downTheFallLine/crabora/software/walk/README.md

# CRABORA walk

Main gait and locomotion code. Starting fresh — the previous generation
(`walk.py` … `walk6.py`, `tripod_walk.py`, `stand*.py`, `take_step.py`,
`teach_pose.py`) was deleted on 2026-10-10 and is recoverable from git
history if a specific idea is worth retrieving.

This document fixes the conventions everything in here depends on.
Get these wrong and a gait that is mathematically perfect will walk
backwards, or tear a leg off against its neighbour.

## Body geometry

The body is a hexagon with one leg on each of the six flats, so a
**hexagon vertex (a "point") falls between each adjacent pair of legs**.

The **front of the robot is the point between leg 1 and leg 6.**

Legs are numbered **1 … 6 clockwise, viewed from above.**

```
                   FRONT
                     ·  ← front point, between legs 6 and 1
                    ╱ ╲
          6 ·                 · 1
          (330°)             (30°)

      5 ·                         · 2
      (270°)                     (90°)

          4 ·                 · 3
          (210°)             (150°)
                    ╲ ╱
                     ·  ← rear point, between legs 3 and 4
```

Bearings above are measured **clockwise from the front point**, which is
the natural reading of "clockwise order": leg *n* sits at
`30° + (n-1) × 60°`.

| Leg | Bearing | Position |
|-----|---|---|
| 1 | 30° | front-right  |
| 2 | 90° | right |
| 3 | 150° | rear-right |
| 4 | 210° | rear-left |
| 5 | 270° | left |
| 6 | 330° | front-left |

The rear point sits between legs 3 and 4, directly opposite the front.

Note there is **no leg on the centreline**, front or back. The robot
leads with a point, not with a leg, so forward motion is symmetric
about the 1/6 and 3/4 pairs.

## Body frame

Right-handed, origin at the body centre on the deck plane:

- **+X** forward, out through the front point
- **+Y** to the **left** (port)
- **+Z** up

So a leg's bearing θ (clockwise from front, as tabulated) maps to a
direction vector `(cos θ, −sin θ, 0)` — the sign on Y because bearings
run clockwise while the frame is right-handed.

This matches the usual robotics convention (ROS REP-103). It is a
choice, not a measurement: if anything else in the codebase already
assumes otherwise, change it **here** and fix the code, rather than
letting two conventions coexist.

## Servo IDs

Two-digit scheme, unchanged from the rest of the project:

```
    ID = leg × 10 + joint        joint: 1 = coxa, 2 = femur, 3 = tibia
```

| Leg | Coxa | Femur | Tibia |
|-----|---|---|---|
| 1 | 11 | 12 | 13 |
| 2 | 21 | 22 | 23 |
| 3 | 31 | 32 | 33 |
| 4 | 41 | 42 | 43 |
| 5 | 51 | 52 | 53 |
| 6 | 61 | 62 | 63 |

## Tripod groups

Alternating legs, which with this numbering gives two valid tripods:

- **Tripod A** — legs 1, 3, 5
- **Tripod B** — legs 2, 4, 6

Each group has two legs on one side and one on the other, straddling
the centre of mass. One tripod is always in stance while the other
swings.

## Mirror symmetry

Legs 1–3 are the right side, 4–6 the left. A leg and its mirror
(1↔6, 2↔5, 3↔4) are physically identical parts rotated into place, so
**a positive coxa command swings them in opposite directions in the body
frame.** Gait code must apply a per-side sign, not assume one direction
for all six.

This is the single most likely source of a leg driving into its
neighbour. It bit the previous generation — the tripod gait's coxa
direction was never verified on hardware.

**This generation's table is verified.** On 2026-10-10 `tripod_coxa.py`
drove all six coxas together on the test stand, with the two tripods
opposing as intended and no `--invert` needed. `FORWARD_SIGN` in
`gait_lib.py` is correct as written. `--invert` stays as a diagnostic:
if a later run needs it, a servo has been remounted.

## The femur

**Centre (2048) is the femur horizontal**, and the travel envelope is
**±90°** — straight up to straight down. Decided 2026-10-10.

### Why centre is horizontal

The alternative was centre = the neutral stance pose, which makes gait
maths read naturally (swing is a positive offset from zero) at the cost
of lopsided limits. Horizontal was chosen instead: it is a pose you can
identify by eye when calibrating, it is geometrically easy to reason
about, and it makes the limits symmetric. The price is that every stance
command carries a constant offset from centre.

### Up and down are not the same job

Unlike the coxa — where forward and rear are the same action mirrored,
so symmetric travel is natural — the femur's two directions do different
work:

- **Up** — swing clearance (small, 15–25°), and folding into a tuck or
  park pose (large). Also how the robot gets up from a collapsed start.
- **Down** — raises the body above neutral ride height. Useful range
  runs out quickly: as the femur drops the leg straightens, the foot
  pulls inward, and mechanical advantage falls away.

So although the *envelope* is symmetric at ±90°, the *useful* range is
not, and gait code should not assume that +30° and −30° are equally
available or equally cheap. Down is also gravity-assisted while up works
against the leg's weight, so the two directions differ in torque and in
how a move settles.

### Femur sign — verified

The coxa mirror comes from **body geometry**: legs 1 and 6 point
different ways, so "forward" is opposite rotations. The femur has no
equivalent — *lift is the same physical motion on every leg.*

So the femur sign should be **uniform across all six legs, not mirrored
like the coxa.**

**Confirmed on hardware 2026-10-11.** All six femurs moved together, so
the reasoning holds and one sign serves every leg. The run also showed
the direction was backwards from the first guess: **a rising servo count
LOWERS the femur**, so `FEMUR_UP_SIGN` in `gait_lib.py` is −1 everywhere,
not +1.

If a later run shows the two sides splitting — legs 1–3 rising while 4–6
drop — a servo has been remounted and the table would need per-side
values after all.

### Travel limits

Pick them from the hardware, not from this document. With torque off,
swing each femur by hand through its full range and find where it
actually fouls — cap against coxa body, tibia against femur, leg against
neighbour — then set limits a few degrees inside that. `set_center.py`
takes independent left/right values, so asymmetric limits need no new
code:

```
python3 utils/set_center.py 12 50 25     # leg 1 femur: 50° up, 25° down
```

## The tibia

**Centre (2048) is the tibia COLLINEAR WITH THE FEMUR** — the leg dead
straight, zero knee bend. Decided 2026-10-11.

### Why collinear

The deciding factor is **repeatability across six legs**. Centre is set
six times by hand with `set_center.py`, and the legs have to match. A
straight leg can be pressed against a table edge or a straightedge — it
is physically repeatable, not judged by eye. The alternative (tibia
perpendicular to the femur) means eyeballing a right angle six times,
and if leg 3 ends up 5° off leg 1 the robot limps in a way that is
miserable to trace back.

Secondary: zero knee bend = zero is the standard way to parameterise a
knee, so the tibia angle is simply "flexion from straight" for any IK
written later. And it is the same *kind* of reference as
femur-horizontal — a geometric datum you can verify, not a working pose.

### Travel is one-sided

A knee only bends one way, so **straight is the edge of useful travel,
not the middle.** There is almost nothing on the extend side and all of
it on the flex side — roughly 0 to 120–135° of flex. Firmware limits
will be lopsided (something like 5° extend, 120° flex) and that is
correct, not a mistake: nothing requires centre to be centred.

The direct consequence is that **code sweeping this joint symmetrically
is the wrong shape.** `proto_walk_tibia.py` therefore takes separate
`--extend` and `--flex` angles rather than one `--angle`; a symmetric
sweep would clamp against the extend limit on every leg, every rep.

### Tibia sign

`TIBIA_EXTEND_SIGN` is **+1 everywhere, verified on hardware 2026-10-12**
(`tests/test_05_calibration.py --signs --legs 1 4`). Both predictions
from the other two joints held except one:

- **Uniform across all six, not mirrored** — as expected. Legs 1 and 4
  are one per side and both extended, so the sides did not split. Flexing
  a knee is the same physical motion on every leg, exactly as lifting is
  for the femur. The coxa's mirror comes from body geometry and has no
  analogue at the knee.
- **+1, not −1** — the femur needed inverting from its first guess and
  this one did not, so the tibia servos do *not* follow the femur's
  mounting convention.

This was the last unverified joint sign. All three tables in
`gait_lib.py` now match hardware.

## Link geometry

Read from the CAD and confirmed against the built leg with calipers on
2026-10-11. All distances are between **joint axes** — the centre of
each servo horn — which is the kinematic quantity, not part edges.
They live in `gait_lib.py`.

| Parameter | Value | Meaning |
|---|---|---|
| `BODY_TO_COXA_AXIS` | 163.22 mm | body centre → coxa axis, horizontal, along the leg's bearing |
| `COXA_RADIAL` | 58 mm | coxa axis → femur axis, outboard |
| `COXA_TANGENT` | 21 mm | coxa axis → femur axis, **sideways** |
| `COXA_VERTICAL` | 17.6 mm | coxa axis → femur axis, up |
| `FEMUR_LEN` | 100 mm | femur axis → tibia axis |
| `TIBIA_LEN` | 120 mm | tibia axis → foot tip |

### The leg is not a planar 2-link chain

Worth flagging because it is easy to get silently wrong: the femur axis
is **not** directly outboard of the coxa axis. It is displaced 21 mm
sideways and 17.6 mm up. So the femur/tibia plane is offset from the
coxa rotation axis rather than passing through it.

Any IK written against the textbook "yaw joint plus planar 2-link"
model will be subtly wrong — the tangent term has to be carried through.
The error would be small enough to look like calibration drift, which
is the worst kind of bug to chase.

### Measuring these again

If a leg revision changes them, there is an easy repeat procedure now
that the centre conventions are fixed. Command one leg to centre on all
three joints — coxa neutral, femur horizontal, tibia collinear — and
**the leg becomes a straight horizontal line from the femur axis out to
the foot.** Everything is then measurable with a steel rule in one pose,
with no angles to judge. Measure horn-centre to horn-centre; the central
horn screw marks the axis.

## Still undefined

Deliberately not fixed here yet, because they want measuring on the
assembled robot rather than guessing:

- ~~Joint zero poses~~ — all three are now settled: coxa neutral, femur
  horizontal, tibia collinear with the femur. Set them with
  `software/utils/set_center.py`.
- ~~Joint angle signs~~ — all three are settled and verified on
  hardware: coxa 2026-10-10, femur 2026-10-11, tibia 2026-10-12.
- ~~Travel limits~~ — set on hardware as of 2026-10-11. Every joint's
  safe swing is now written into servo firmware, so a bad command is
  clamped by the servo itself rather than by the calling code.

## Bring-up order

Power is the binding constraint (see the project power notes — the
LM2596 buck tops out around 2–3 A, which is fine for exercising joints
but will not stand the robot). Build up a tier at a time:

1. All six coxas bolted → `software/tests/test_04_coxa_sweep.py`
2. Add femurs → `software/utils/swing_legs.py --mode by-joint`
3. Add tibias → same, then static stance
4. Standing, then walking — needs the power path sorted first

## walk.py

Translates the body across the floor with the feet planted. **The idea is
`turn.py`'s, with translation substituted for rotation** — both are "foot
fixed in the world, re-solve the leg", and the only difference is what the
body does between solves:

| | the planted foot appears to |
|---|---|
| turn | rotate about the body centre |
| walk | translate, opposite the heading |

That discipline is the whole point. Swinging the coxa and hoping is what
lost two thirds of the first turn: the foot slid radially, and a foot
sliding radially has no grip to push with either.

A hexagon with radial legs has no mechanical front, so it walks sideways
and backwards without turning first — heading is just a vector. 0 is
forward (the point between legs 1 and 6), 90 left, 180 back, 270 right.

```bash
python3 walk.py 300 --dry-run        # geometry only, touches nothing
python3 walk.py 300                  # 300 mm forward, 100 mm deck
python3 walk.py 200 --heading 180    # backwards
python3 walk.py 400 --stride 150     # longer steps, fewer of them
```

`--instrument` measures what actually happened, rather than what was
commanded: swing-foot clearance after each LIFT and SWEEP, body tilt at
the same points, and the heading change across the whole walk.

That last one is the only thing the walk can measure that a static test
cannot. A straight walk should end on the heading it started on; if it
veers, that is **asymmetric slip** — one side gripping better than the
other — and it is invisible by eye over 150 mm.

The clearance figures are computed from joint angles, which makes them
**body-relative**: they measure the swing foot against the stance feet,
and when the body sinks, both move down together. The tilt reading is
there to catch what they cannot. Note an accelerometer sees tilt but not
uniform sink, so the two together still do not replace a ruler.

**Default height is 100 mm**, not 80. The femur caps hang 21 mm below the
deck and the body drops another ~13 mm when a tripod lifts, so 80 leaves
about 46 mm of real gap under the lowest hardware against 66 at 100.
Measured on hardware 2026-10-14: standing at 94 mm gave 73 mm under the
caps and a clean tripod lift, where 75 mm did not. The stride cap falls
from ±84 mm to ±72 mm, still far more than a 50 mm stride needs — so the
height costs nothing that matters.

`--dry-run` prints the per-leg coxa angles at both sweep extremes, which
is where the asymmetry shows: walking forward, the **beam legs (2 and 5)
sweep most** (±8.0° at a 25 mm half-stride) because they are
perpendicular to travel, so their motion is almost pure tangent. The
corner legs take ±4.6°, since part of their motion is radial — a reach
change rather than a coxa swing. Which legs have the hard job depends on
the heading, so the stride cap is computed per leg.

**Verified in simulation, not on hardware.** Foot drift through a full
sweep is 0.000000 mm on forward, backward, left, right and diagonal
headings — the same check `turn.py` had to pass. Stride is capped by
whichever comes first, leg reach or the coxa limit: ±84 mm forward, ±77 mm
sideways at 80 mm height. None of that is the same as having walked.

## scurry.py

walk.py's gait, streamed on a clock instead of stop-and-wait. walk.py
sends a frame, then polls all 18 servos until every one has stopped,
seven times a step at 300 steps/s. That is how it learned the gait works,
and it is why the robot stops dead seven times a step.

scurry.py instead computes, at a fixed rate (50 Hz), where every foot
should be at that instant and sends all eighteen goals in one sync-write
packet per URT. No replies, no waiting. The geometry is walk.py's
`stance_pose()`, unchanged; what is new is the timing:

- each tripod is down for `--duty` of the cycle (0.55), so both tripods
  are briefly on the floor together at each changeover
- the swing foot leaves and lands moving with the floor (a Hermite curve
  on the stride, a raised cosine on the femur), so lift-off and
  touchdown carry no velocity jump
- the cycle rate ramps up over the first period and down over the last

```bash
python3 scurry.py 500 --dry-run          # plan, joint speeds, touches nothing
python3 scurry.py 500                    # 3 s cycles, ~67 mm/s
python3 scurry.py 500 --period 2.5       # then shorten a step at a time
```

**It is open loop.** walk.py knew whether each joint arrived; this does
not ask. In place of that it reads supply voltage every 0.2 s and stops
below `--min-volts` (6.5), and ends the run on any bus error. Stopping
means planting whichever feet are up and holding, torque on. It also
reads one servo's real position and current every 0.05 s, round-robin,
and reports each joint's tracking error and lag at the end -- a
measurement, not a guard. The currents show live in agentix.

**Speed: stride is cheap, lift is expensive.** The femur does all the
lifting, inside the swing, so its speed scales with lift and not
stride; body speed scales with stride and not lift. So scurry's
defaults differ from walk.py's: a 120 mm stride (asked; capped to what
the legs hold, swing overshoot included), 20° lift, and feet 110 mm out
instead of 120 (it moves them in from the stand pose and back). At the
default 3 s period that plans ~67 mm/s, against ~30 mm/s with walk.py's
geometry.

`--dry-run` refuses anything needing over 1500 steps/s from any joint
(half an unloaded STS3215, as a guess at what a loaded one will follow)
unless `--allow-fast` is passed. The tracking report is how to replace
that guess. `--period 1.7 --duty 0.5` plans ~118 mm/s with the tibia at
~1420. Past a ~1.6 s period the stream needs more acceleration than the
servo register holds (25,400 steps/s²), so the plan sets it unlimited
and suggests `--rate 100`.

**Not yet run on hardware.** Tested against a fake bus: 50 Hz held with no
late frames, the packets decode with valid checksums, and the low-voltage
stop plants and holds.
