downTheFallLine/crabora/doc/mounts-spacer.md

## Mounts & Standoffs

### Coxa Connection

1.	Use 12.5mm spacer
2.	Use 20mm bolt

### Femur Connection

1. Use 6MM spacer
2. Use 14MM bolt

### Tibia Connection

1. Use 6MM spacer
2. Use 14MM bolt

### Coxa Cap

4x50mm bolts

### Femur Cap

4x40mm bolts

### Tibia Cap

4x45 or 4x50 bolts   50 preferred
