downTheFallLine/crabora/imu/imu_bracket.png

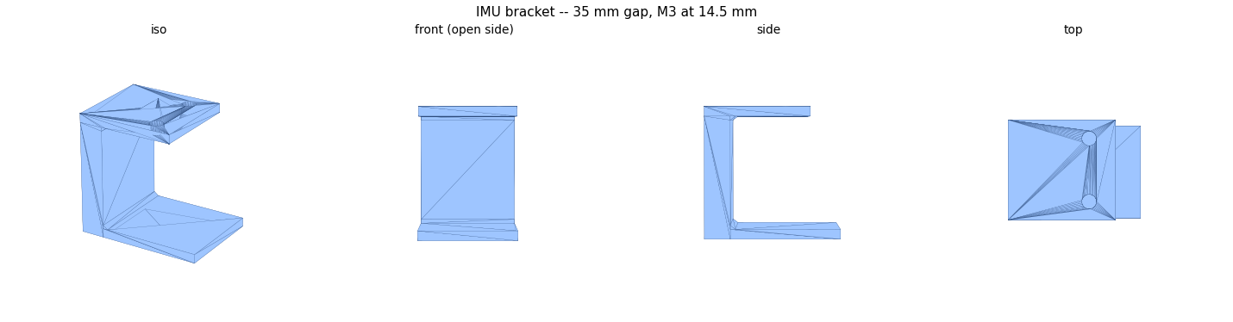
imu/imu_bracket.png
