downTheFallLine/crabora/leg/coxa/coxa_body_cap.png

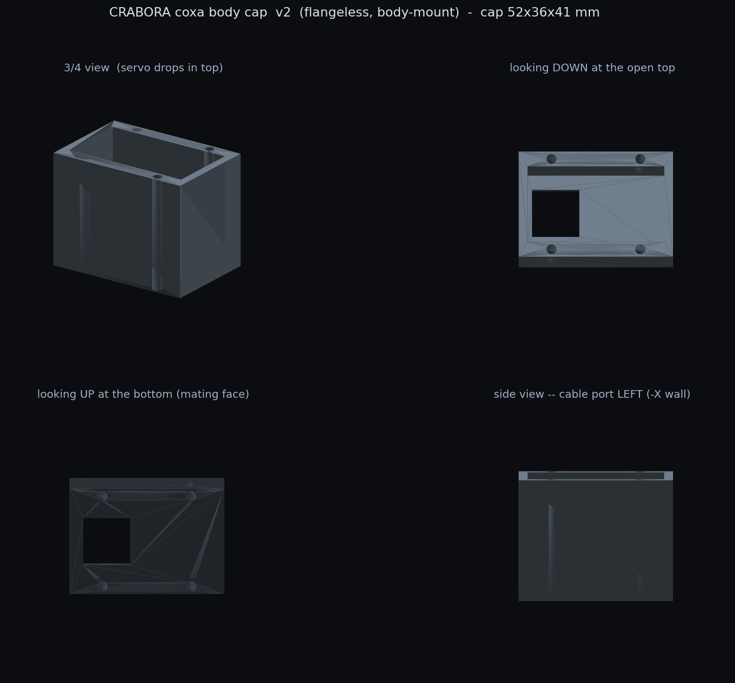
leg/coxa/coxa_body_cap.png
