downTheFallLine/crabora/leg/coxa/coxa_body_mount.png

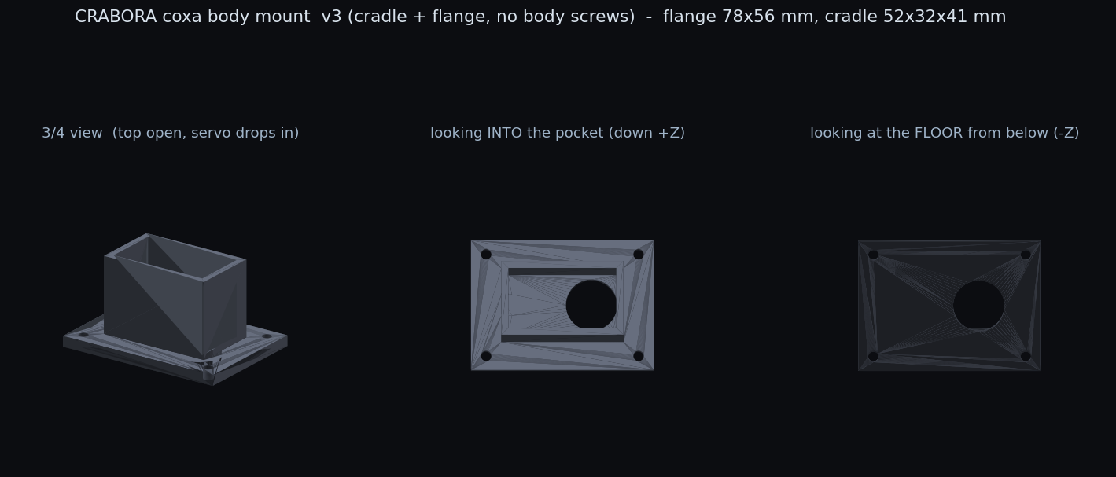
leg/coxa/coxa_body_mount.png
