downTheFallLine/crabora/leg/coxa/linkage_leg/coxa_pan.png

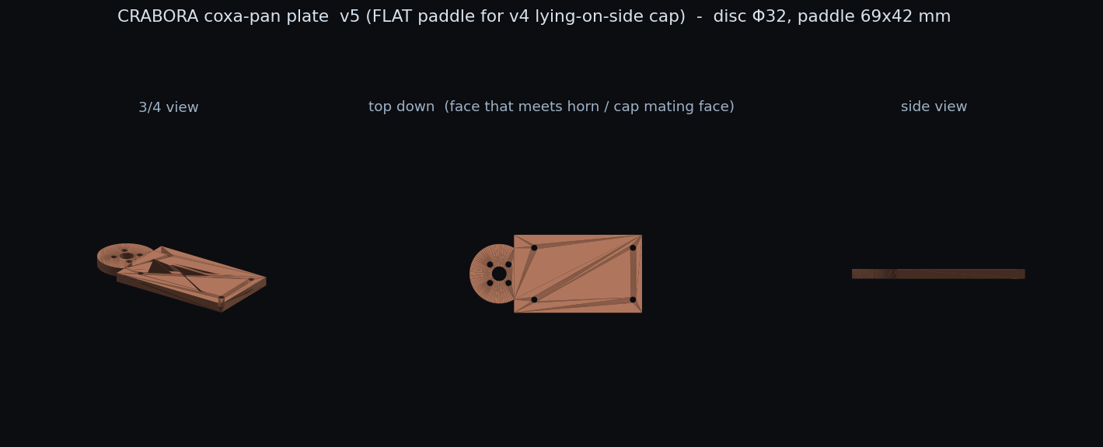
leg/coxa/linkage_leg/coxa_pan.png
