downTheFallLine/crabora/leg/femur/femur_cap.png

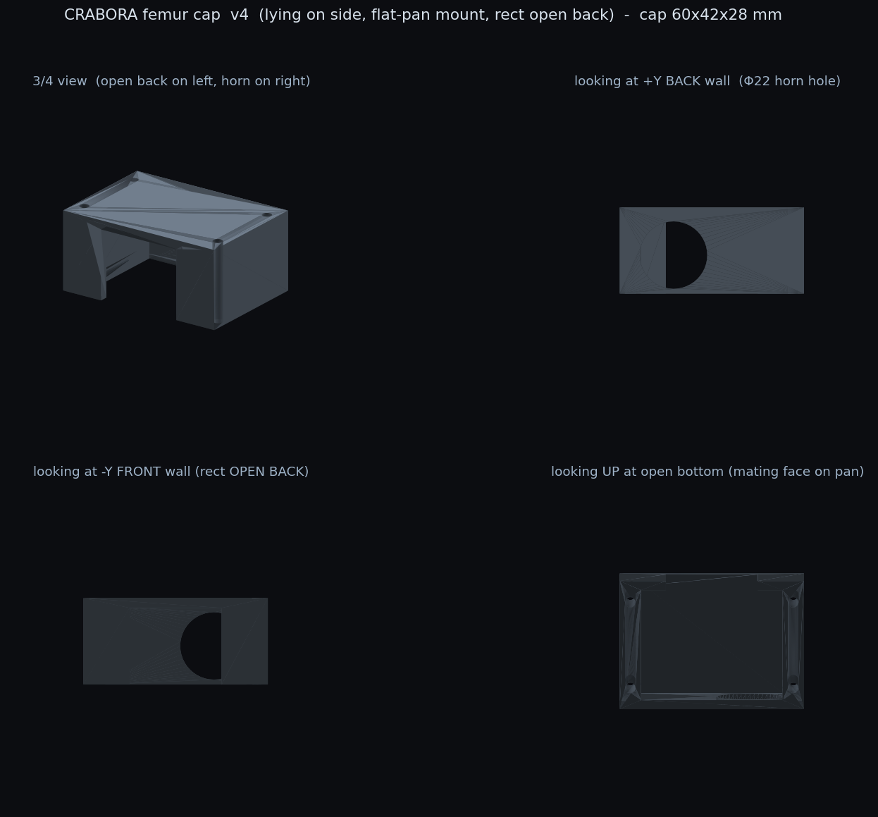
leg/femur/femur_cap.png
