downTheFallLine/crabora/leg/femur/linkage_leg/femur_link.png

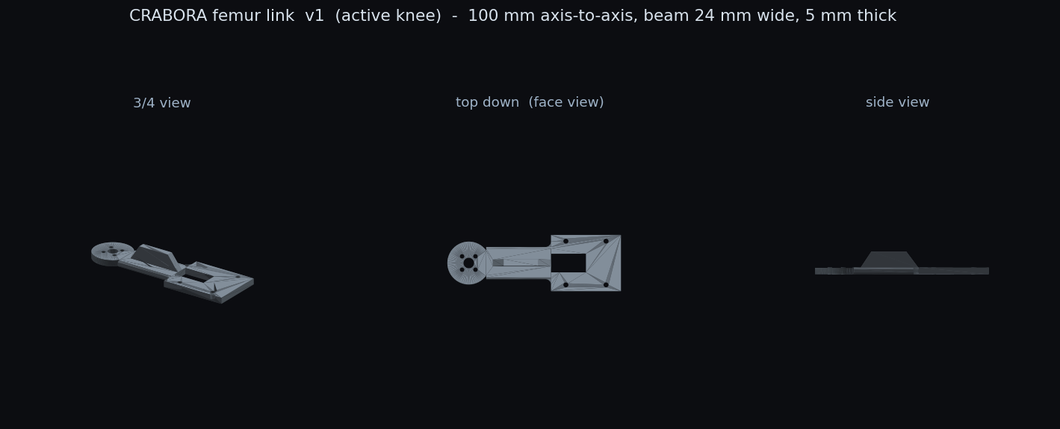
leg/femur/linkage_leg/femur_link.png
