downTheFallLine/crabora/leg/tibia/linkage_leg/tibia_link.png

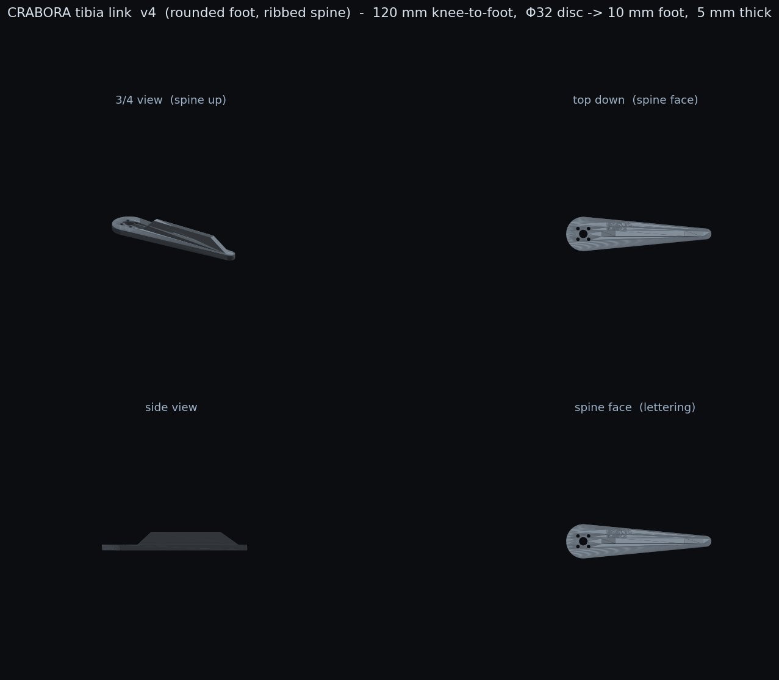
leg/tibia/linkage_leg/tibia_link.png
