downTheFallLine/crabora/leg/tibia/tibia_cap.png

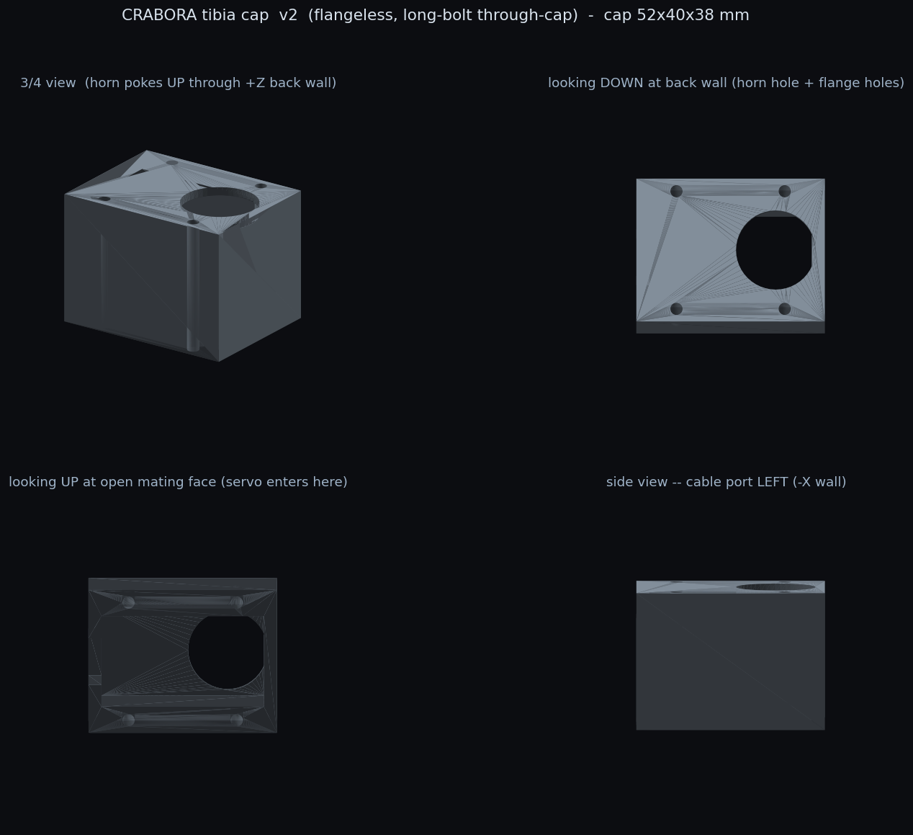
leg/tibia/tibia_cap.png
