downTheFallLine/crabora/sled/buck_sled.png

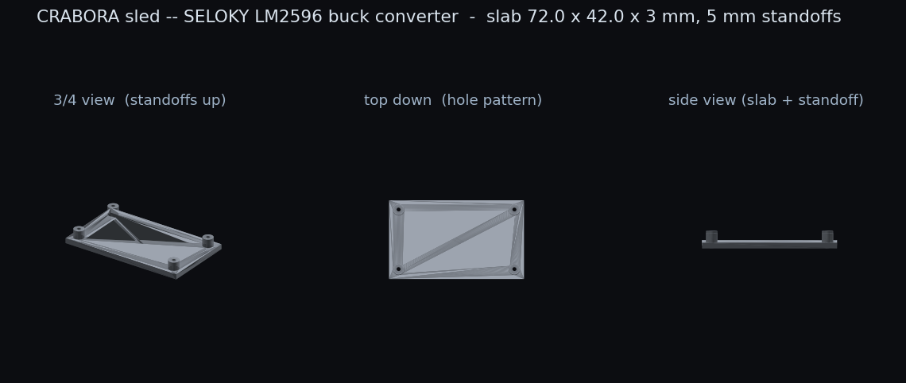
sled/buck_sled.png
