downTheFallLine/crabora/spacer/spacer/horn_spacer.png

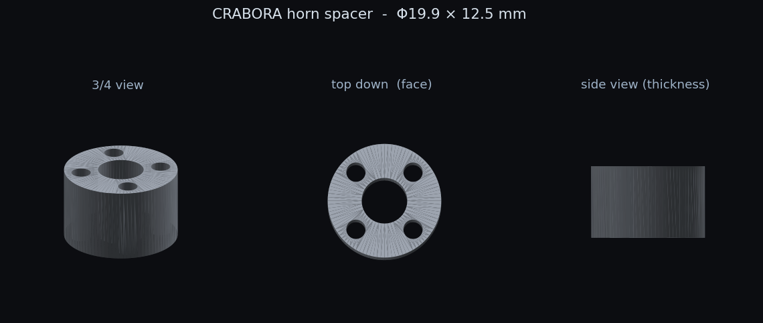
spacer/spacer/horn_spacer.png
