downTheFallLine/crabora/doc/Crabora-status.xlsx

Sheet: Read me
CRABORA — project state
Six-legged robot. Feetech STS3215 servos on 3x FE-URT-2, driven from a Raspberry Pi running Ubuntu.
What this workbook is
A snapshot of where the project stands as of 14 October 2026, built to make the open questions visible rather than to track tasks.
The sheets
Status every subsystem, what state it is in, and how that was established
Open items what is left, ordered by what blocks what
Measurements every number taken off the hardware, with its source and how far to trust it
Decisions choices made and why, so they are not relitigated
Changes what was built and fixed on 13-14 October
The one thing to take away
Power is the root problem. The buck converter has NEVER regulated: a 2S pack feeds an LM2596 asked for 7.4 V, which needs ~9.4 V in, so servo voltage simply tracks the battery down all session. Supply fell 6.5 → 5.5 V over one evening, below the servos' 6.0 V minimum.
Because of that, repeating a measurement an hour later gave a different answer, and a great deal of time went into chasing robot problems that were battery problems. Until it is fixed, every number here has a shelf life.
Confidence, as used throughout
HARDWARE measured on the robot, repeated or cross-checked
SIM computed or simulated only; never run on the robot
EYE observed by a person, not instrumented
ASSUMED carried forward without evidence; treat as a guess

Sheet: Status
Subsystem status
State and how it was established. Colour follows state; see the Read me for what each confidence level means.
Subsystem | State | Confidence | What is true today | Established by | Where
Joint sign calibration | DONE | HARDWARE | All three signs verified: coxa mirrored, femur -1, tibia +1, none of them guessed any more. | test_05_calibration.py --signs, 12 Oct | software/walk/gait_lib.py
Travel limits | DONE | HARDWARE | Set in servo firmware, identical across all 18 joints. Coxa +/-60, femur +/-80, tibia -135..+90. | test_05_calibration.py | servo firmware
Stand / recovery | WORKS | HARDWARE | Collapse, untangle, stand. Reaches 94-100 mm deck. Four legs fell short once at 150 mm, which is 90% of max reach. | stand.py, 14 Oct | software/stand/stand.py
Untangle | WORKS | HARDWARE | Rewritten to fold all six legs then rotate all six coxas, instead of one leg at a time. Safer: nothing rotates while a neighbour is extended. | stand.py, 14 Oct | software/stand/stand.py
Tripod lift | DONE | HARDWARE | 90 mm of clearance at 35 deg, confirmed by eye and by IMU. Femurs reach within 0.3 deg. Body tilts only 0.87 deg. | test_07_tripod_lift.py, 14 Oct | software/tests/
Walk | UNRUN | SIM | Planted-foot gait, same maths as turn with translation substituted for rotation. Foot drift 0.000 mm in simulation on five headings. NEVER RUN ON HARDWARE. | simulation only | software/walk/walk.py
Turn | UNVERIFIED | EYE | Planted-foot sweep. Originally 90 deg commanded produced 30-45 deg measured by eye. Never instrumented; the IMU can now measure it directly. | eye, before the IMU existed | software/turn/turn.py
Dance | WORKS | EYE | Runs. Never instrumented or measured. | ran on hardware | software/dance/dance.py
IMU | PARTIAL | HARDWARE | Wired, detected at 0x68, reading tilt. NOT CALIBRATED: |g| reads 1.042 on every sample, a constant 4% scale error. Differences are still trustworthy; absolute tilt is not. | test_06, 14 Oct | software/imu_lib.py
Power / supply | BROKEN | HARDWARE | The buck has never regulated. 2S into an LM2596 asked for 7.4 V needs ~9.4 V in. Observed 6.5 V falling to 5.5 V in one session, below the 6.0 V servo minimum. | read_servo_voltage.py, repeatedly | hardware
Bus reliability | DONE | SIM | Lost replies now retried twice and counted, so a motion that limped through says so. Serial exceptions caught rather than escaping as tracebacks. | synthetic packet handler | software/walk/gait_lib.py
agentix service | WORKS | HARDWARE | Runs at boot via systemd, serves the UI, holds the servo ports. Credentials in /etc/crabora/agentix.env, root-owned 0600. | running on the Pi | software/agentix/
agentix motion tools | UNRUN | SIM | Seven motions behind a human ARM switch the agent cannot flip. Argument rejection and the gate are verified; no motion has ever executed. | static checks only | software/agentix/motion.py
agentix chat | UNRUN | ASSUMED | Needs an org-level key plus ANTHROPIC_WORKSPACE_ID, or a workspace-scoped key. Never completed a request. | never run | software/agentix/agent.py
IMU bracket | PARTIAL | SIM | C-section sled, 35 mm gap, M3 at 14.5 mm. Geometry verified in 3D. Not yet printed or fitted. | geometry checks | imu/design_imu_bracket.py
WiFi hotspot | UNRUN | SIM | Fallback AP so the robot is reachable away from the house network. Exercised against a stubbed nmcli; no real radio has run it. | stub only | software/net/hotspot.sh

Sheet: Open items
What is left, in order
Priority is about what blocks what, not about how interesting it is. The two blockers are both power.
Priority | Item | Effort | Why it matters | Blocked by | Unblocks
1 BLOCKER | Charge the battery | Minutes | Supply fell to 5.5 V, under the servos' 6.0 V minimum. Every measurement taken below that is a measurement of the battery. | Nothing | Everything downstream
1 BLOCKER | Move to a 3S pack | An afternoon | The real fix. 2S can never give the LM2596 its ~2 V of headroom, so servo voltage tracks the battery down and nothing reproduces. 3S regulates properly all session. | Parts | Repeatable measurement of anything
2 HIGH | Calibrate the IMU | Minutes | |g| = 1.042 on every sample. Until this runs, absolute tilt carries a 4% scale error. | Nothing | Trustworthy absolute tilt
2 HIGH | Run the instrumented walk | An hour | The measurement the whole project is waiting on. Gives three numbers at once: distance travelled vs commanded, heading drift (asymmetric slip), and whether clearance collapses mid-sweep. | Charged battery | Whether the robot walks
2 HIGH | Tape-measure the actual distance | Minutes | No sensor on this robot can measure translation; accelerometer double-integration drifts uselessly within seconds. A tape is the instrument. | The walk running | Slip vs scrub, settled
3 MEDIUM | Verify the turn with the IMU | An hour | turn.py exists because 90 deg commanded gave 30-45 by eye. Yaw measures it directly, and over a few seconds gyro drift is negligible. The IMU's most reliable use here. | Charged battery | turn --efficiency becomes calibration not guesswork
3 MEDIUM | Reconcile TRIPOD_SAG | Minutes | Still the 13 mm ruler figure, which measures uniform sink. The IMU reports 5 mm of lean. Different quantities; both are real and the constant should say which it is. | A walk on a good battery | Honest clearance predictions
3 MEDIUM | agentix with a real API key | An hour | The motion path has never executed. Everything is verified statically, which is not the same as having run. | Key with workspace scope | The agent can actually drive the robot
4 LOW | Print and fit the IMU bracket | A print | The IMU currently has no proper mount. Nothing on the bracket keys its orientation, so fitting it backwards inverts every heading. | Printer time | A repeatable IMU mounting
4 LOW | Decide turn and dance heights | Minutes | Both still default to 80 mm while stand and walk moved to 100. Deliberately left: a turn loads the legs differently and deserves its own measurement. | A verified turn | Consistency, or a reason not to be
4 LOW | Delete the git backup refs | Minutes | backup-before-purge and backup-branch still hold ~26 MB of pre-purge history locally. Safe to drop once the Pi is confirmed happy. | Confidence in the Pi | 26 MB
4 LOW | Decide on software/dance.sh | Minutes | Exists only on the Pi, untracked. Either commit it or delete it. | Nothing | One less loose end

Sheet: Measurements
Everything measured off the hardware
SIM values are computed from the geometry and have been wrong before — the computed clearance was optimistic for a whole evening because it cannot see the body move.
Area | Quantity | Value | Unit | Confidence | Source | Notes
Geometry | BODY_TO_COXA_AXIS | 163.22 | mm | HARDWARE | Calipers, 11 Oct | Body centre to coxa axis
Geometry | COXA_RADIAL | 58 | mm | HARDWARE | Calipers, 11 Oct | Coxa axis to femur axis, outward
Geometry | COXA_TANGENT | 21 | mm | HARDWARE | Calipers, 11 Oct | Sideways offset. The leg is NOT a planar 2-link chain because of this.
Geometry | COXA_VERTICAL | 17.6 | mm | HARDWARE | Calipers, 11 Oct | Coxa axis to femur axis, vertical
Geometry | FEMUR_LEN | 100 | mm | HARDWARE | Calipers, 11 Oct | Femur axis to tibia axis
Geometry | TIBIA_LEN | 120 | mm | HARDWARE | Calipers, 11 Oct | Tibia axis to foot tip
Geometry | CAP_DROP_BELOW_DECK | 21 | mm | HARDWARE | Ruler, 13 Oct | Femur caps hang this far below the deck. The kinematics did not know they existed; leg_fk measures to the femur AXIS.
Sag | TRIPOD_SAG (uniform sink) | 13 | mm | HARDWARE | Ruler, 13 Oct | Chassis went 46 -> 33 mm when one tripod lifted, while the stance femurs gave about 1 deg. Mechanical: flex, backlash, feet sliding.
Sag | Body lean when a tripod lifts | 0.86-0.87 | deg | HARDWARE | IMU, 14 Oct, twice | Repeated across two runs on different stances, so this is signal not noise. Equals ~5 mm at a foot 341 mm out.
Clearance | Swing foot lift at 35 deg | 90 | mm | HARDWARE | test_07, 14 Oct | Confirmed by eye as well as computed. At 25 deg it was 57 mm.
Clearance | Gap under caps, standing at 100 mm deck | 79 | mm | SIM | computed | deck height minus the 21 mm cap drop
Clearance | Gap under caps, tripod lifted, 100 mm deck | 66 | mm | SIM | computed | minus the 13 mm measured sink. 80 mm deck gives only 46.
Lever | Foot rise per degree of FEMUR | 2.09 | mm/deg | SIM | computed at a standing pose | The only useful lever for lifting a foot.
Lever | Foot rise per degree of TIBIA | -0.41 | mm/deg | SIM | computed at a standing pose | NEGATIVE: more tibia flex LOWERS the foot, and throws it 2 mm outward per degree.
Lever | Body height lost per degree of femur sag | 2.08 | mm/deg | SIM | computed | Constant across stand heights.
Power | Supply at session start | 6.5 | V | HARDWARE | read_servo_voltage, 13 Oct | Already below the 7.4 V the buck is set for.
Power | Supply at session end | 5.5 | V | HARDWARE | test_07, 14 Oct | BELOW the STS3215's 6.0 V minimum. Rose to 5.8 V the moment three legs unloaded.
Power | Servo spec range | 6.0 - 7.4 | V | ASSUMED | vendor listings, not the datasheet | Sources conflict; one outlier says 8.4. The servos store their own limits in registers 14/15 — read those.
Gait | Foot drift through a sweep | 0.000 | mm | SIM | simulation, 5 headings | The planted-foot solve is exact in the model. Any real sliding is traction, not commanded scrub.
Gait | Stride capacity, forward at 100 mm | +/-72 | mm | SIM | computed | Far more than the 50 mm default stride needs.
Gait | Beam legs (2,5) coxa sweep, forward | +/-8.0 | deg | SIM | computed | Against +/-4.6 for the corner legs: beam legs are perpendicular to travel so their motion is nearly pure tangent.
Bracket | IMU bracket resonance | ~471 | Hz | SIM | cantilever calculation | A foot plant rings the structure at 50-200 Hz, so the mount stays clear. A 4 mm web would have been 310 Hz.

Sheet: Decisions
Decisions and why
Recorded so they are not relitigated, and so the reasoning survives when the context does not.
When | Decision | Why | Cost / trade | Caveat
14 Oct | Stand and walk default to 100 mm, not 80 | 80 predates knowing the femur caps hang 21 mm below the deck and the body sinks another 13 mm. That leaves 46 mm under the lowest hardware, which is where the chassis bottoms out instead of the legs holding it. | Stride capacity falls from +/-84 to +/-72 mm, still far more than needed. | turn and dance stay at 80 pending their own measurement.
14 Oct | Untangle moves all six legs together | One leg at a time still let a leg rotate its coxa while neighbours lay extended — the 440 mm lever sweep the phase exists to prevent, just between legs instead of within one. | No extra current: collapse already moved six femurs at once. | Femurs before tibias, same ordering lesson that cost a tibia.
14 Oct | Gait programs REFUSE when the service holds the bus | It was a warning, and it was answered past three times running, each time corrupting a move and stranding the robot mid-sequence. | --force exists but has never worked. | The service holds the ports even when the chat agent is disabled — those are different things.
14 Oct | Default lift 35 deg, not 25 | Buys 90 mm of clearance against 57 for nothing; the femur has travel to spare. | Exposed a settle bug that 25 deg had been hiding. | Treats a symptom if the body is sinking — not a substitute for height.
13 Oct | The femur is the lift lever, not the tibia | Measured: femur 2.09 mm/deg against the tibia's -0.41, and more tibia flex LOWERS the foot while throwing it outward. | Settles a natural but wrong instinct. | Checked numerically after it was proposed, not assumed.
13 Oct | Bus retries are counted and reported | A retry that hides a fault is worse than the abort it replaces: a browning-out supply drops packets exactly like a loose connector. | A motion completing after forty re-sends now says so. | Only safe because goal/speed/torque writes are idempotent.
12 Oct | agentix motion sits behind a human ARM switch | The failure worth designing against is not a model going berserk, it is a robot left armed on a bench that lurches when someone later asks an innocent question. | Window expires on idle, hard ceiling at 30 min, dropped by STOP. | The agent cannot arm itself: /api/arm is unreachable from the tool layer.
12 Oct | Motion reuses the verified CLI programs | Two tibias have snapped from motions that looked geometrically reasonable. Nothing in the agent layer invents a trajectory. | turn.py's sweep was lifted out of main() rather than copied. | A second copy of a gait is how the third tibia breaks.
12 Oct | Credentials live outside the repo | A key in a working tree is one `git add -A` from being published — which is exactly how 177 MB of venv got committed later the same day. | /etc/crabora/agentix.env, root-owned 0600. | The .gitignore now uses .venv*/ after the venv leak.

Sheet: Changes
Built and fixed, 13-14 October
Not a changelog — the entries that changed what is known about the robot.
Area | What changed | Why it mattered | Where
IMU | Wired and brought up on Ubuntu | raspi-config does not exist there and the boot config is at /boot/firmware/config.txt, which no MPU-6050 guide mentions. | doc/imu.md
IMU | Attitude measurement in test 7 | Measures the one thing the encoders structurally cannot: where the body actually is. | tests/test_07_tripod_lift.py
IMU | Tilt and heading in the walk | Clearance from joint angles is body-relative and blind to the body sinking. Heading catches asymmetric slip, invisible by eye over 150 mm. | walk/walk.py, imu_lib.py
IMU | C-section mounting bracket designed | 35 mm gap, M3 at 14.5 mm, top plate stopping 6 mm past the bolts. | imu/design_imu_bracket.py
Walk | walk.py written | turn.py's planted-foot maths with translation substituted for rotation. Walks any heading because a hexagon has no mechanical front. | walk/walk.py
Walk | Measures its stance instead of assuming it | It took --height on faith; a body sitting 60 mm low makes the swing legs scuff and looks exactly like a gait with no lift. | walk/walk.py
Stand | Untangle rewritten to move all legs together | Faster, and safer: nothing rotates until everything is folded. | stand/stand.py
Bus | Lost replies retried and counted | One dropped packet used to abort a whole motion. | walk/gait_lib.py
Bus | Serial exceptions caught, service collision refused | pyserial can raise, not just return a status code, and that escaped as a traceback mid-collapse. | walk/gait_lib.py and all five gait programs
Fix | delta_degrees added; nudge_joint was wrong by 180 deg | to_counts is a pure scale but to_degrees subtracts centre — they are not inverses, and passing a difference is silently wrong. | walk/gait_lib.py, agentix/motion.py
Fix | test 7 waits for the move before measuring it | A flat 1.5 s settle against a 1.99 s move read servos in flight as servos failing under load — an 11.9 deg phantom shortfall. | tests/test_07_tripod_lift.py
Repo | 177 MB venv purged from history | A CAD venv named .venv-cad slipped past a bare .venv/ in .gitignore, was committed, pushed, and pulled to the Pi. | .gitignore now uses .venv*/
