downTheFallLine/crabora/unibody/deck_assembly.stl

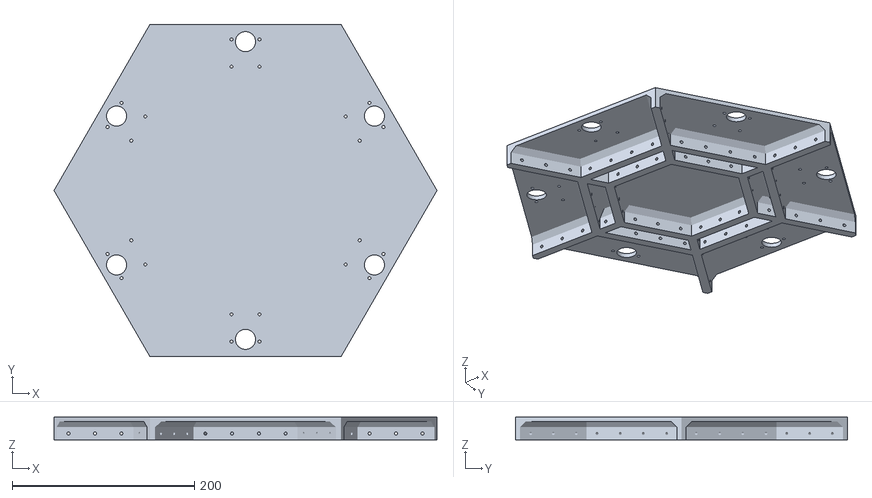
[picture p11: CAD file, 2026-10-09]
unibody/deck_assembly.stl
419.9 x 363.6 x 25.0
