downTheFallLine/crabora/imu/imu_bracket.stl

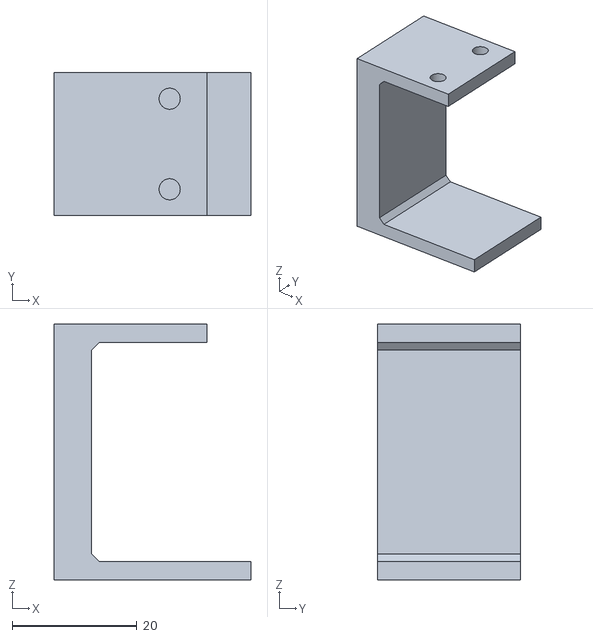
[picture p12: CAD file, 2026-10-14]
imu/imu_bracket.stl
31.5 x 22.9 x 41.0
