downTheFallLine/crabora/leg/coxa/coxa_body_mount.stl

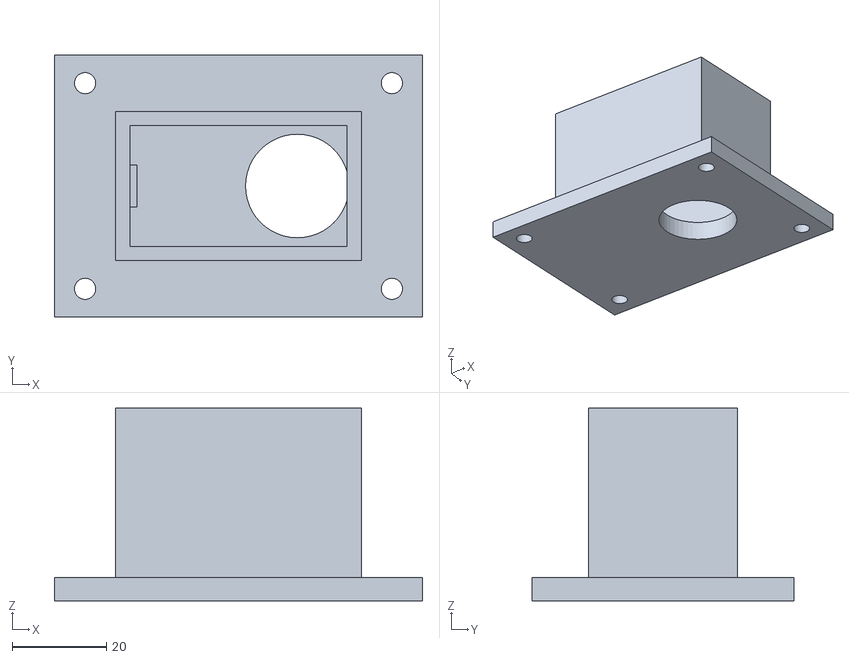
[picture p13: CAD file, 2026-09-22]
leg/coxa/coxa_body_mount.stl
78.2 x 55.7 x 41.0
