downTheFallLine/crabora/leg/coxa/linkage_leg/coxa_body_cap.stl

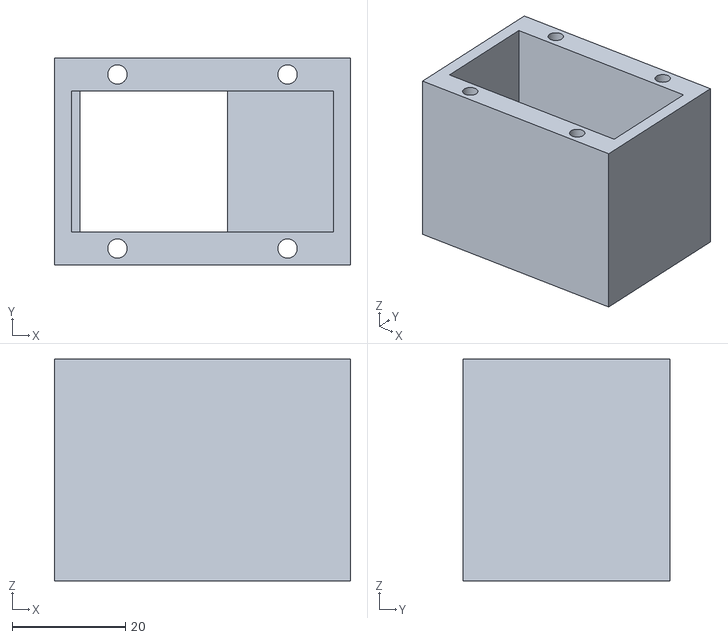
[picture p14: CAD file, 2026-09-29]
leg/coxa/linkage_leg/coxa_body_cap.stl
52.2 x 36.5 x 39.1
