downTheFallLine/crabora/leg/femur/femur_link.stl

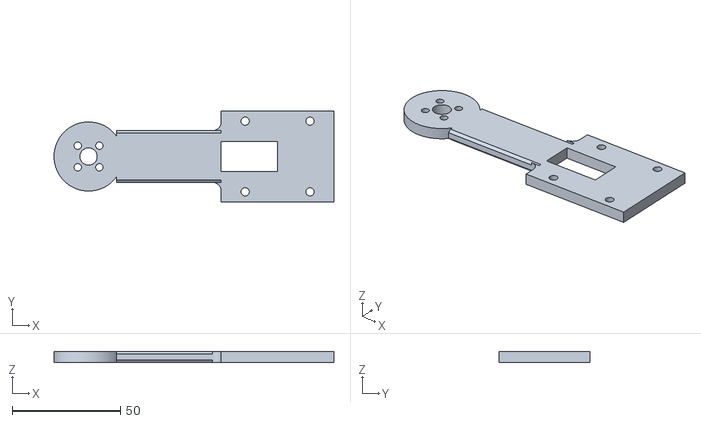
[picture p15: CAD file, 2026-09-22]
leg/femur/femur_link.stl
129.6 x 42.0 x 5.00
