downTheFallLine/crabora/leg/femur/linkage_leg/femur_link.stl

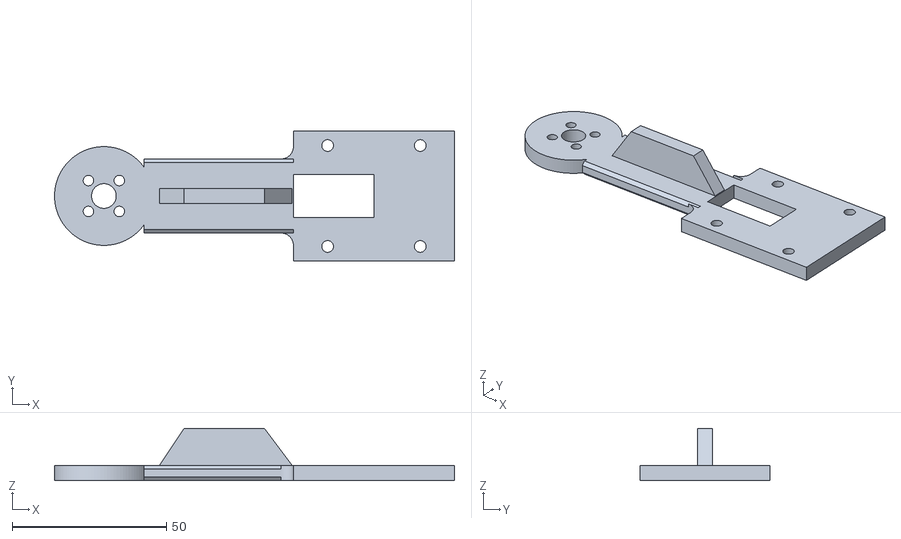
[picture p16: CAD file, 2026-10-12]
leg/femur/linkage_leg/femur_link.stl
129.6 x 42.0 x 17.0
