downTheFallLine/crabora/leg/tibia/linkage_leg/tibia_link.stl

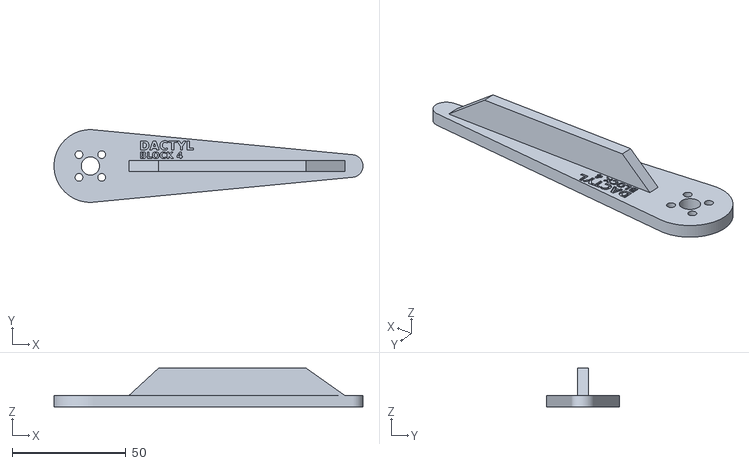
[picture p17: CAD file, 2026-10-12]
leg/tibia/linkage_leg/tibia_link.stl
136.0 x 32.0 x 17.0
