downTheFallLine/crabora/leg/tibia/tibia_cap.stl

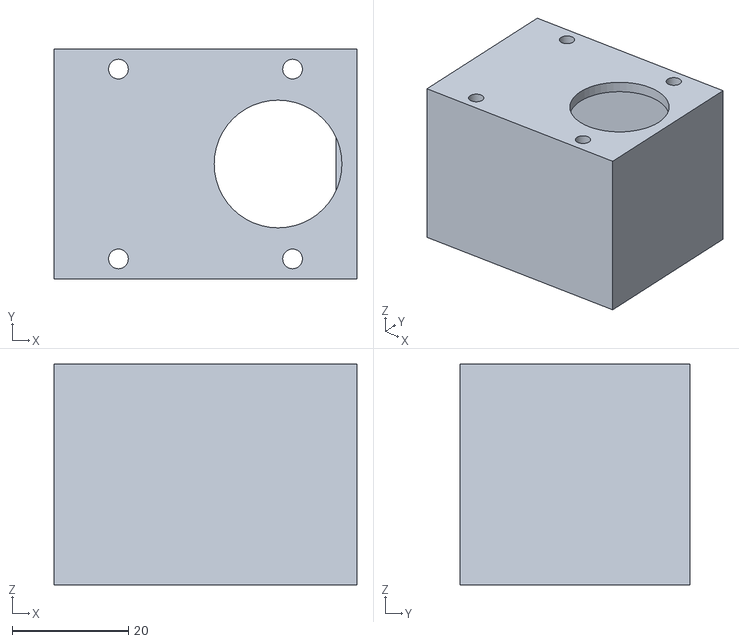
[picture p18: CAD file, 2026-10-06]
leg/tibia/tibia_cap.stl
52.2 x 39.7 x 38.0
