downTheFallLine/crabora/shims/coxa_cap_shim.stl

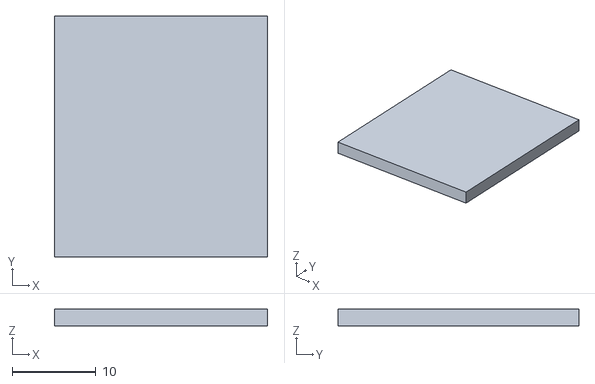
[picture p19: CAD file, 2026-09-22]
shims/coxa_cap_shim.stl
25.5 x 28.8 x 2.00
