downTheFallLine/crabora/sled/buck_sled.stl

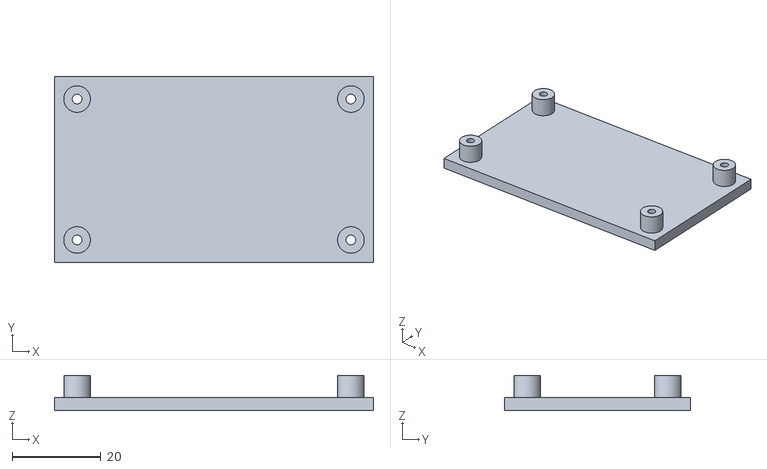
[picture p20: CAD file, 2026-10-10]
sled/buck_sled.stl
72.0 x 42.0 x 8.00
