downTheFallLine/crabora/spacer/spacer/horn_spacer.8.5mm.stl

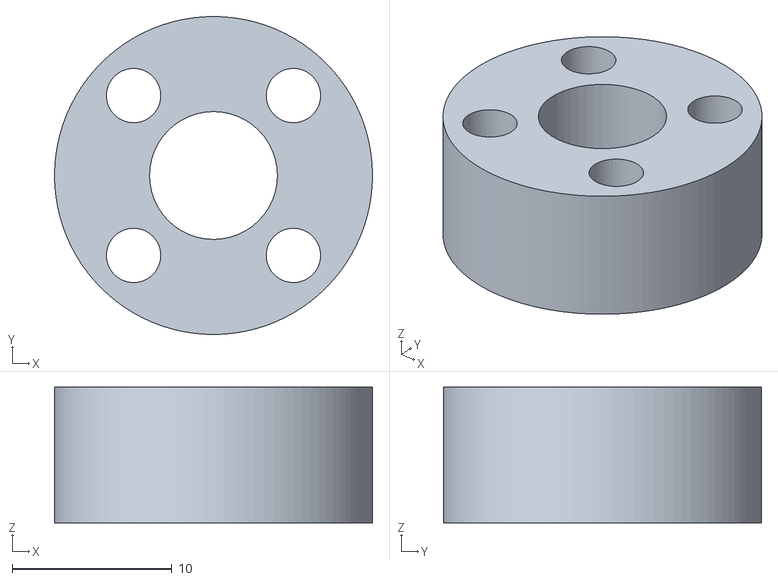
[picture p21: CAD file, 2026-10-06]
spacer/spacer/horn_spacer.8.5mm.stl
19.9 x 19.9 x 8.50
