downTheFallLine/crabora/standOffs/standoff.stl

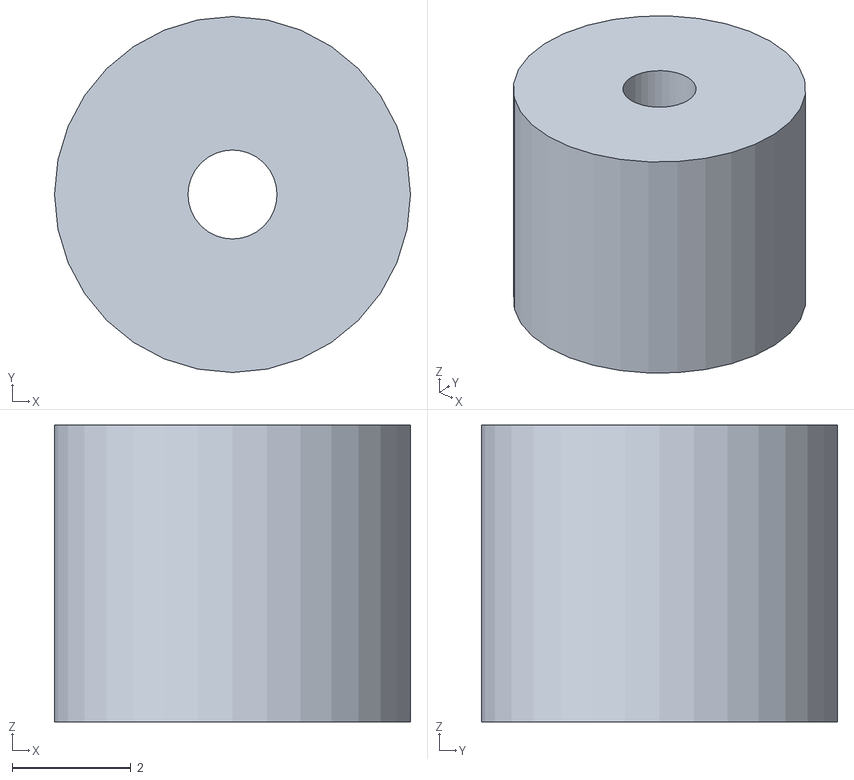
[picture p22: CAD file, 2026-09-22]
standOffs/standoff.stl
6.00 x 6.00 x 5.00
