downTheFallLine/crabora/leg/coxa/coxa_pan.stl

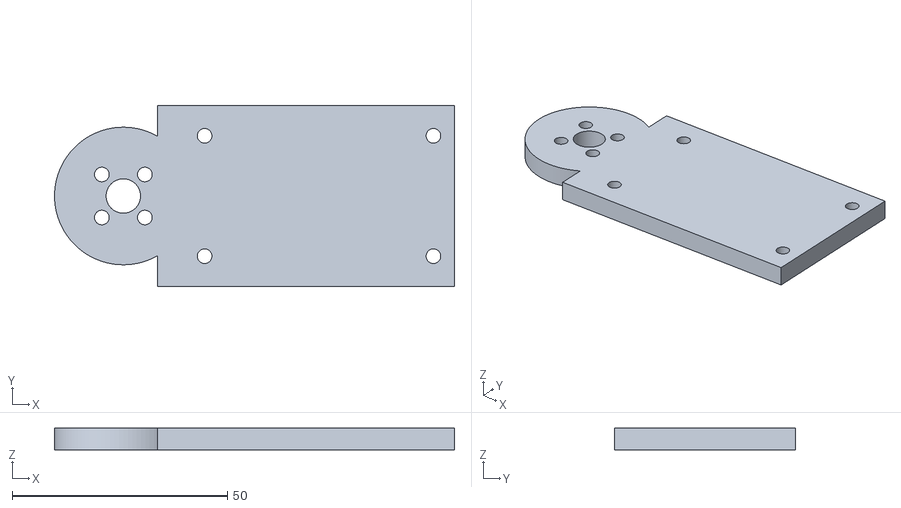
[picture p23: CAD file, 2026-09-22]
leg/coxa/coxa_pan.stl
93.0 x 42.0 x 5.00
