downTheFallLine/crabora/leg/femur/femur_cap.stl

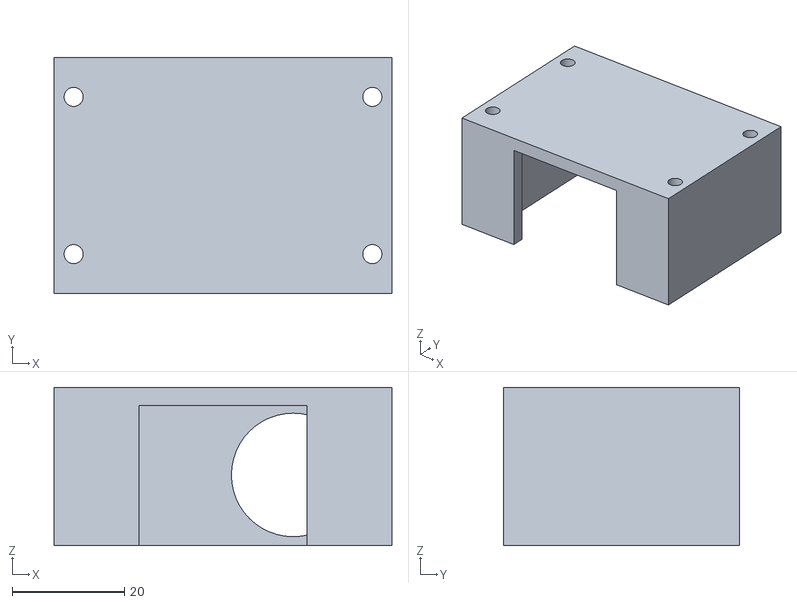
[picture p24: CAD file, 2026-09-22]
leg/femur/femur_cap.stl
60.2 x 42.0 x 28.2
