downTheFallLine/crabora/leg/tibia/tibia_link.stl

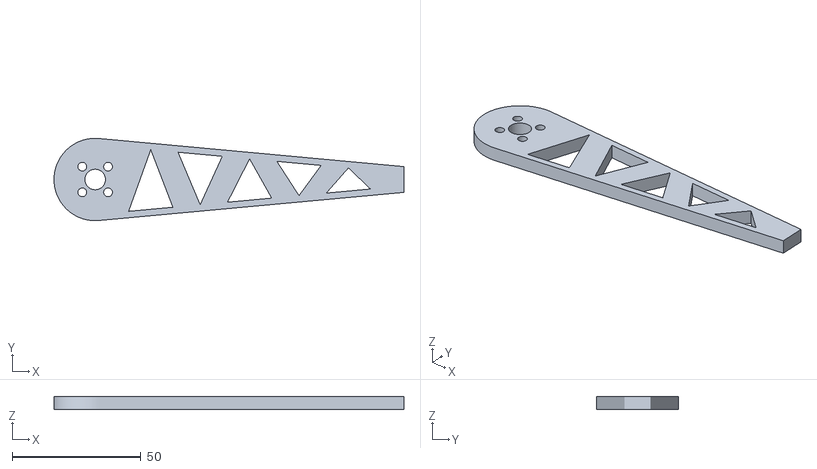
[picture p25: CAD file, 2026-09-22]
leg/tibia/tibia_link.stl
136.0 x 32.0 x 5.00
