downTheFallLine/crabora/shims/side_shim.stl

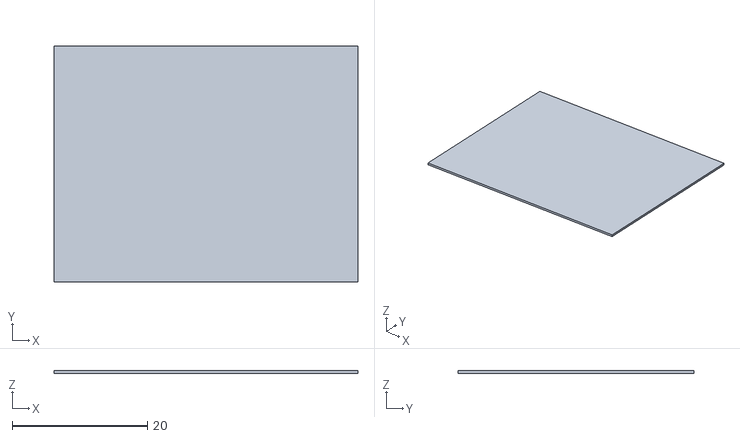
[picture p26: CAD file, 2026-09-22]
shims/side_shim.stl
45.0 x 35.0 x 0.4
