downTheFallLine/crabora/sled/urt_sled.stl

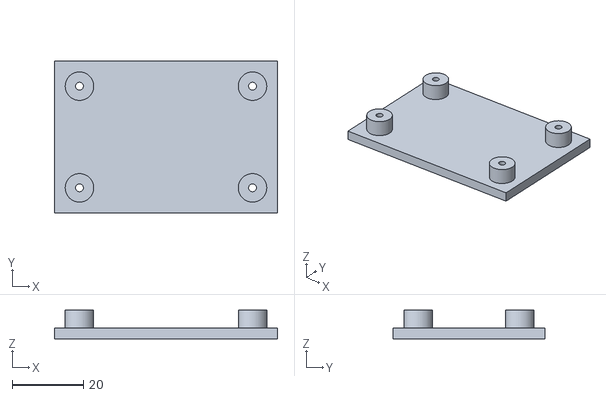
[picture p27: CAD file, 2026-10-10]
sled/urt_sled.stl
62.5 x 42.5 x 8.00
