downTheFallLine/crabora/spacer/spacer/horn_spacer.12.5mm.stl

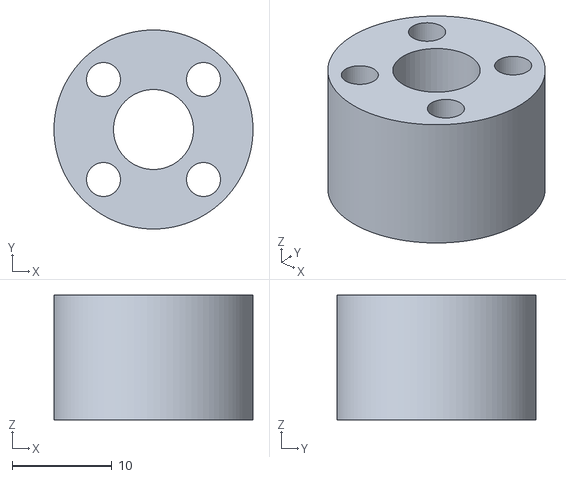
[picture p28: CAD file, 2026-10-06]
spacer/spacer/horn_spacer.12.5mm.stl
19.9 x 19.9 x 12.5
