downTheFallLine/crabora/unibody/deck_outer.stl

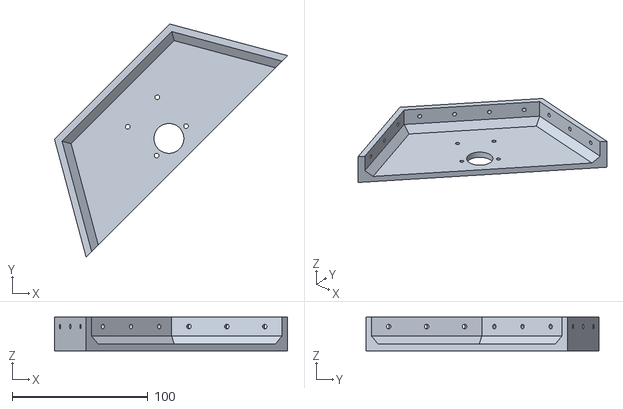
[picture p29: CAD file, 2026-10-09]
unibody/deck_outer.stl
171.7 x 171.7 x 25.0
