downTheFallLine/crabora/leg/coxa/coxa_body_cap.stl

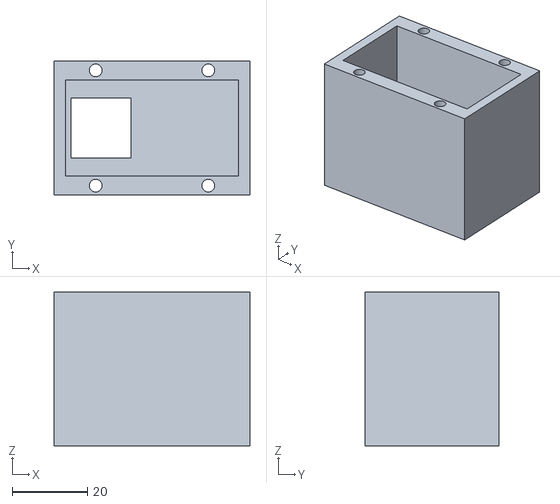
[picture p30: CAD file, 2026-09-22]
leg/coxa/coxa_body_cap.stl
52.2 x 35.7 x 41.0
