downTheFallLine/crabora/spacer/spacer/horn_spacer.6.6.stl

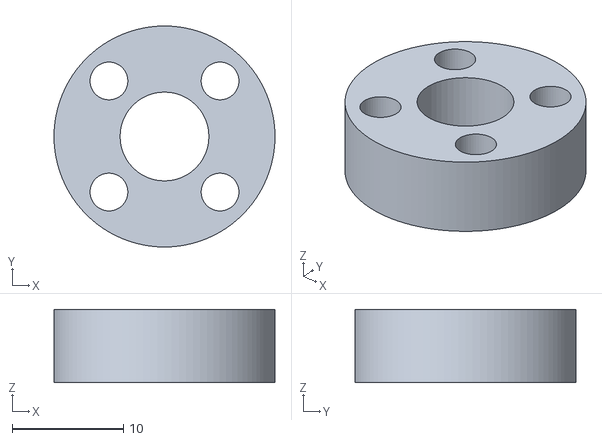
[picture p31: CAD file, 2026-10-06]
spacer/spacer/horn_spacer.6.6.stl
19.9 x 19.9 x 6.60
