downTheFallLine/crabora/unibody/deck_hub.stl

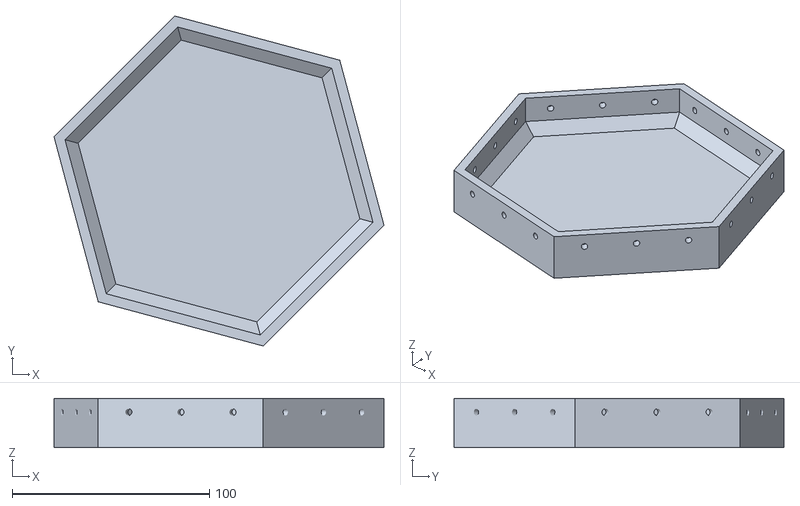
[picture p32: CAD file, 2026-10-09]
unibody/deck_hub.stl
167.5 x 167.5 x 25.0
