downTheFallLine/crabora/spacer/spacer/horn_spacer.stl.8mm.stl

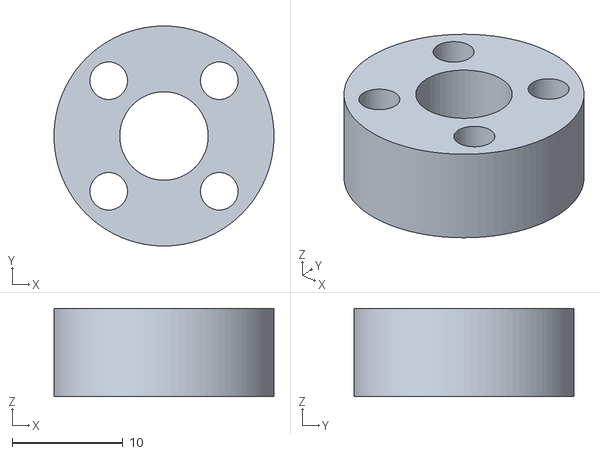
[picture p33: CAD file, 2026-10-06]
spacer/spacer/horn_spacer.stl.8mm.stl
19.9 x 19.9 x 8.00
