downTheFallLine/crabora/unibody/deck_mid.stl

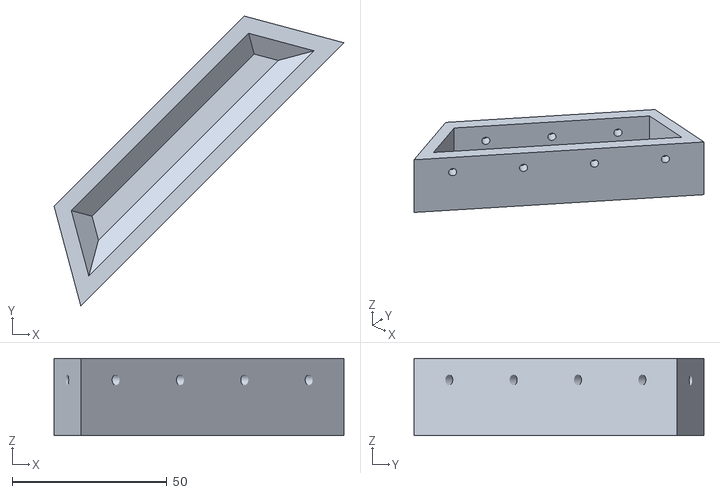
[picture p34: CAD file, 2026-10-09]
unibody/deck_mid.stl
93.6 x 93.6 x 25.0
