downTheFallLine/crabora/spacer/spacer/horn_spacer.stl.6mm.stl

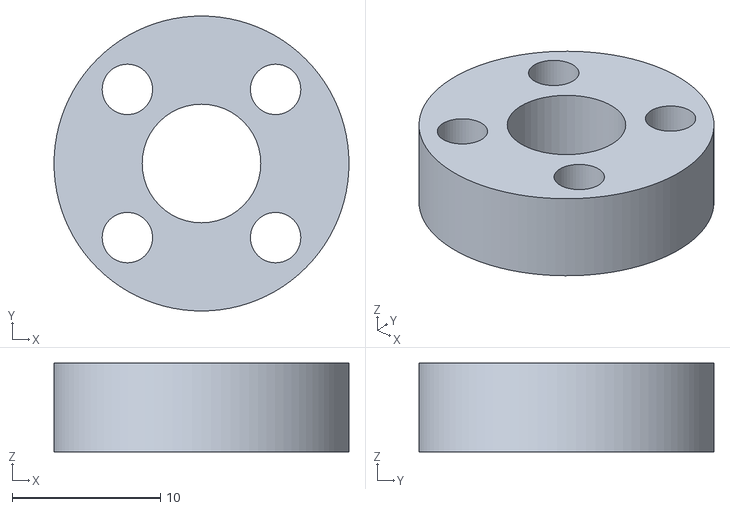
[picture p35: CAD file, 2026-10-06]
spacer/spacer/horn_spacer.stl.6mm.stl
19.9 x 19.9 x 6.00
