downTheFallLine/crabora/unibody/mid_ring.stl

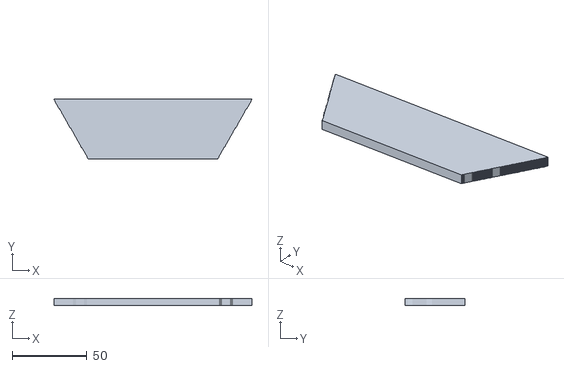
[picture p36: CAD file, 2026-09-22]
unibody/mid_ring.stl
132.3 x 39.9 x 5.00
