downTheFallLine/crabora/unibody/outer_ring_v2.stl

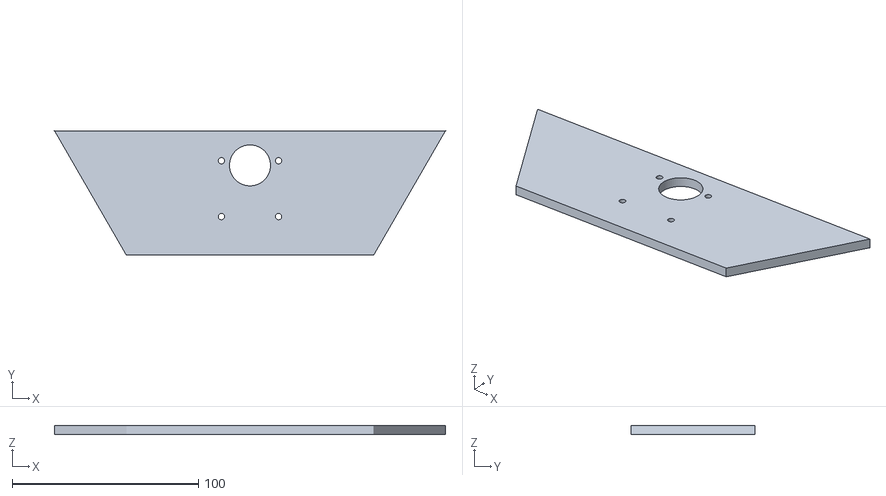
[picture p38: CAD file, 2026-09-22]
unibody/outer_ring_v2.stl
210.0 x 66.8 x 5.00
