downTheFallLine/crabora/unibody/hub_v2.stl

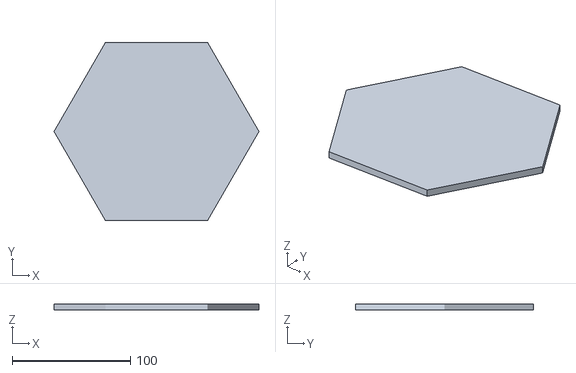
[picture p39: CAD file, 2026-09-22]
unibody/hub_v2.stl
173.4 x 150.1 x 5.00
