downTheFallLine/crabora/unibody/brace.stl

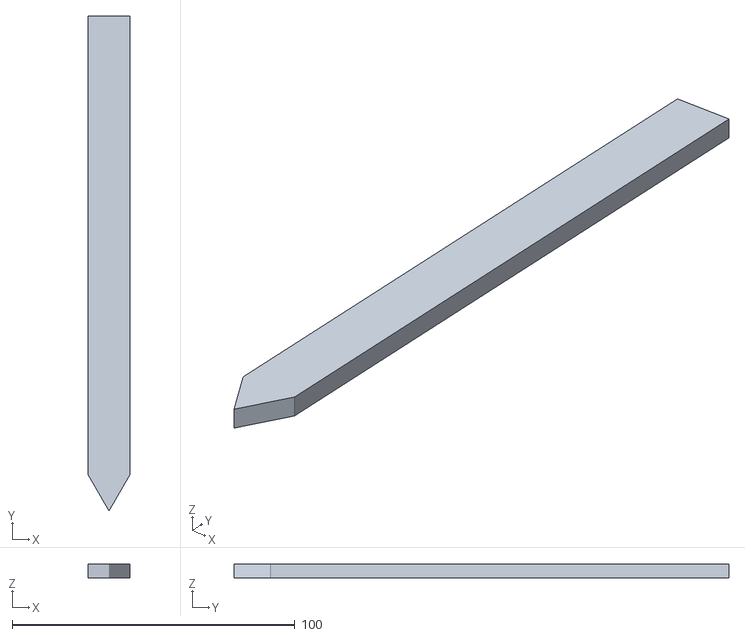
[picture p40: CAD file, 2026-09-22]
unibody/brace.stl
15.0 x 175.0 x 5.00
