downTheFallLine/crabora/(list of files, cad)

Other CAD files:
leg/femur/linkage_leg/femur_cap.stl
spacer/spacer/horn_spacer.stl.10mm.stl
unibody/outer_ring.stl
unibody/mid_ring_v2.stl
unibody/hub.stl
