downTheFallLine/crabora/leg/coxa/assembly_coxa_step.png

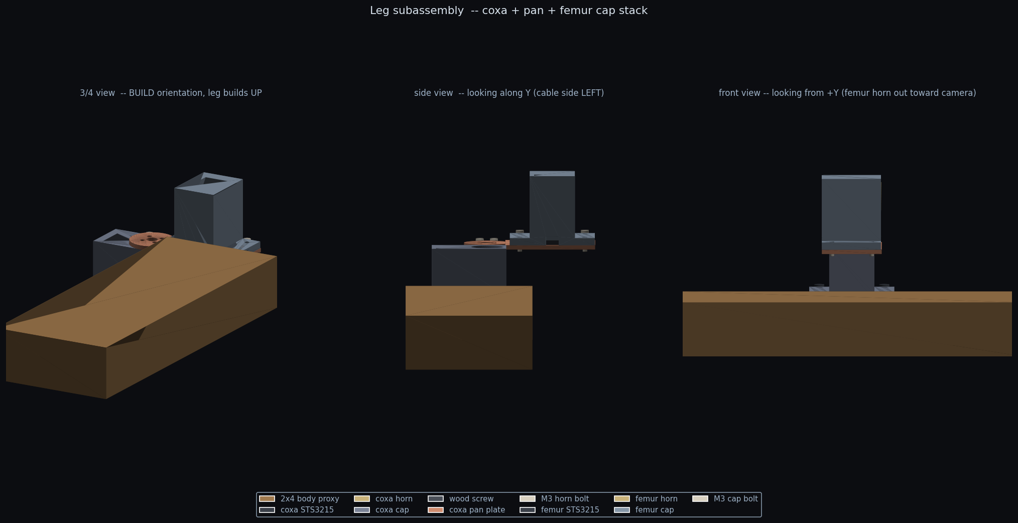
leg/coxa/assembly_coxa_step.png
