downTheFallLine/crabora/software/walk/gait_lib.py

"""
CRABORA gait_lib -- shared conventions and bus plumbing for software/walk
===========================================================================

Everything in software/walk/ imports its geometry constants and servo
access from here, so there is exactly one place where "which way is
forward" is defined. See README.md for the derivation.

Contents:
  - Geometry: ALL_LEGS, LEG_NAME, LEG_BEARING, FORWARD_SIGN, TRIPOD_A/B
  - Units: to_counts(), to_degrees()
  - Bus: read1/read2/write1/write2, open_ports(), find_coxas(), move_all()
  - Operator: confirm()

Requires: pip install feetech-servo-sdk   (provides the scservo_sdk module)
"""

import os
import sys
import time

try:
    from serial import SerialException
except ImportError:      # pyserial absent: geometry still works
    class SerialException(Exception):
        pass

sys.path.insert(0, os.path.dirname(os.path.dirname(os.path.abspath(__file__))))

# The bus libraries are optional on purpose: the geometry constants and
# sign tables below are pure data, useful for kinematics and analysis on
# a machine with no servo SDK installed. Anything that actually touches
# the bus raises a clear error instead of failing at import time.
try:
    from scservo_sdk import COMM_SUCCESS, PacketHandler, PortHandler  # noqa: F401
    from urt_lib import DEFAULT_BAUDRATE, find_urt_devices  # noqa: F401,E402
    HAVE_BUS = True
except ImportError as _exc:                                  # pragma: no cover
    HAVE_BUS = False
    _BUS_IMPORT_ERROR = _exc
    COMM_SUCCESS = 0
    DEFAULT_BAUDRATE = 1_000_000

    def _no_bus(*_a, **_k):
        raise ImportError(
            f"servo bus libraries are not available ({_BUS_IMPORT_ERROR}). "
            f"Install them with:  python3 -m pip install -r "
            f"software/requirements.txt")

    PacketHandler = PortHandler = find_urt_devices = _no_bus


# =============================================================
# GEOMETRY  (see README.md)
# =============================================================
ALL_LEGS = (1, 2, 3, 4, 5, 6)

# Second digit of the servo ID (see project README): 1 coxa, 2 femur, 3 tibia.
COXA_JOINT_DIGIT  = 1
FEMUR_JOINT_DIGIT = 2
TIBIA_JOINT_DIGIT = 3
JOINT_NAME = {1: "coxa", 2: "femur", 3: "tibia"}

# Bearing clockwise from the front point (the hexagon vertex between
# legs 1 and 6): leg n sits at 30 + (n-1)*60 degrees.
LEG_BEARING = {n: 30 + (n - 1) * 60 for n in ALL_LEGS}

LEG_NAME = {
    1: "front-right", 2: "right", 3: "rear-right",
    4: "rear-left",   5: "left",  6: "front-left",
}

# +1 = counter-clockwise about body +Z moves this foot FORWARD.
# A CCW coxa rotation moves leg n's foot forward by sin(bearing), which
# is positive for legs 1-3 (right side) and negative for 4-6 (left).
#
# ✓ VERIFIED ON HARDWARE 2026-10-10: all six legs driven together by
# tripod_coxa.py swung correctly, the two tripods opposing as intended,
# with no --invert. The mirror is real and this table has it right.
#
# --invert survives as a diagnostic, not a fix: if a future run needs it,
# something changed in how the servos are mounted. If only SOME legs go
# the wrong way, they are mounted inconsistently -- fix that in hardware
# rather than patching individual legs here.
FORWARD_SIGN = {1: +1, 2: +1, 3: +1, 4: -1, 5: -1, 6: -1}

# Sign such that `CENTER + UP_SIGN * counts` raises the femur. A RISING
# servo count LOWERS this joint, so up is -1.
#
# ✓ VERIFIED ON HARDWARE 2026-10-11. Two findings from that run:
#   1. The femurs are NOT mirrored. All six moved together, confirming the
#      prediction: the coxa's mirror comes from body geometry (legs 1 and 6
#      point different ways, so forward is opposite rotations), whereas
#      lift is the same physical motion on every leg. One sign serves all.
#   2. The direction was inverted from the first guess -- the run raised
#      the femurs when the code said "down". Hence -1, not +1.
FEMUR_UP_SIGN = {leg: -1 for leg in ALL_LEGS}

# +1 = a rising servo count EXTENDS this tibia (straightens the knee,
# pushing the foot away from the body). -1 means a rising count flexes it.
#
# ✓ VERIFIED ON HARDWARE 2026-10-12 (test_05_calibration.py --signs
# --legs 1 4). Legs 1 and 4 are one per side, so this settles the mirror
# question too: both extended, so the tibia is NOT mirrored -- uniform
# across all six, like the femur. The first guess of +1 was right; unlike
# the femur, this one did not need inverting.
#
# This was the last unverified joint sign. All three tables now match
# hardware.
TIBIA_EXTEND_SIGN = {leg: +1 for leg in ALL_LEGS}

# Femur centre (2048) is the femur HORIZONTAL; envelope is ±90°, straight
# up to straight down. See README.md -- the envelope is symmetric but the
# useful range is not, and down is gravity-assisted while up is not.
FEMUR_MAX_DEFLECTION_DEG = 90.0

# Tibia centre (2048) is the tibia COLLINEAR WITH THE FEMUR -- the leg
# dead straight, zero knee bend. Decided 2026-10-11; see README.md for
# why (repeatable calibration against a straightedge, and zero = zero
# flexion for later IK).
#
# A knee only bends one way, so centre sits at the EDGE of useful travel,
# not the middle: there is almost nothing on the extend side and all of
# it on the flex side. Code that sweeps this joint symmetrically is the
# wrong shape -- see TIBIA_DEFAULT_EXTEND_DEG / _FLEX_DEG below.
TIBIA_EXTEND_LIMIT_DEG = 15.0    # how far past straight it is worth asking for
TIBIA_FLEX_LIMIT_DEG   = 135.0   # provisional; the real guard is the servo's
                                 # own firmware limits, set with set_center.py

# Alternating tripods: each has two legs on one side and one on the
# other, straddling the centre of mass.
TRIPOD_A = (1, 3, 5)
TRIPOD_B = (2, 4, 6)


# =============================================================
# LINK GEOMETRY  (mm) -- see README.md
# =============================================================
# Taken from the CAD and confirmed against the built leg with calipers
# on 2026-10-11. Distances are between JOINT AXES (the centre of each
# servo horn), which is the kinematic quantity, not part edges.
BODY_TO_COXA_AXIS = 163.22   # body centre -> coxa axis, horizontal, along
                             # the leg's bearing. Derived from the deck:
                             # apothem 181.825 - setback 5 - cap 52.2/2
                             # + horn offset 12.5.

# Coxa axis -> femur axis. NOT a simple outboard length: the femur axis is
# displaced sideways and upwards as well, so the femur/tibia plane is
# OFFSET from the coxa rotation axis rather than passing through it. The
# leg is therefore not a textbook planar 2-link chain on a yaw joint --
# any IK needs the tangent term or it will be quietly wrong.
COXA_RADIAL   = 58.0         # outboard, along the leg's bearing
COXA_TANGENT  = 21.0         # sideways, along the femur horn axis
COXA_VERTICAL = 17.6         # up, above the pan disc bottom

# The femur caps hang BELOW the deck plate, so the robot's real ground
# clearance is less than the deck height every pose calculation reports.
# Nothing in the kinematics knows about them: leg_fk measures to the
# femur AXIS, and the cap is a lump of plastic underneath it.
#
# MEASURED 2026-10-13: 52 mm under the caps while the model reported 73 mm
# of deck clearance. So the lowest hardware sits about this far below the
# number the geometry quotes, and it is the cap, not the deck, that hits
# the floor first.
CAP_DROP_BELOW_DECK = 21.0

# How much the body actually drops when one tripod comes off the floor,
# over and above anything the joint angles show.
#
# MEASURED 2026-10-13: the chassis went 46 mm -> 33 mm when tripod A
# lifted, while the stance femurs gave about one degree. Thirteen
# millimetres the encoders cannot see, so it is mechanical -- structural
# flex, horn and gear backlash, feet sliding outward under the doubled
# load, or all three. Every clearance computed from angles is optimistic
# by at least this much, and by more under a moving load.
TRIPOD_SAG = 13.0


FEMUR_LEN = 100.0            # femur axis -> tibia axis
TIBIA_LEN = 120.0            # tibia axis -> foot tip

# Hexagon deck, flat-to-flat / 2 (unibody/design_flanged_deck.py
# DECK_APOTHEM). A foot closer to the body centre than this is somewhere
# under the deck, which is the geometric test for "folded underneath".
DECK_APOTHEM = 181.825


# =============================================================
# UNITS
# =============================================================
CENTER_POSITION = 2048
COUNTS_PER_REV = 4096
POSITION_TOLERANCE = 20    # counts (~1.8 deg)
MOVE_TIMEOUT = 10.0        # seconds before a move is called stalled


def to_counts(deg):
    return round(deg * COUNTS_PER_REV / 360.0)


def to_degrees(pos):
    """An ABSOLUTE servo position, in degrees from centre.

    Note this is NOT the inverse of to_counts(): it subtracts
    CENTER_POSITION and to_counts() does not. Passing a difference to
    this function is wrong by 180 degrees, silently -- use
    delta_degrees() for that. The asymmetry is baked into too many
    callers to change now, so it is named and guarded instead.
    """
    return (pos - CENTER_POSITION) * 360.0 / COUNTS_PER_REV


def delta_degrees(counts):
    """A DIFFERENCE in counts, in degrees. The true inverse of to_counts().

    Exists because to_degrees() is not it, and the resulting 180-degree
    error is the quiet kind: positions still look plausible, and it only
    shows up as a measurement that is reflected about some arbitrary
    value rather than obviously broken.
    """
    return counts * 360.0 / COUNTS_PER_REV


def ground_clearance(deck_height):
    """Real gap under the robot, given a deck height from the pose model.

    Use this wherever a height is shown to a person. The pose model's
    own figure is a kinematic quantity measured to the femur axis, not a
    gap you could slide a ruler into, and quoting it as though it were
    one is how 73 mm turned out to be 52.
    """
    return deck_height - CAP_DROP_BELOW_DECK


def tripod_gap(deck_height):
    """Real gap under the femur caps while one tripod is lifted.

    The binding constraint when walking, and not an obvious one: the
    feet can be clearing beautifully while the chassis scrapes, because
    the caps hang lower than anything the kinematics models.
    """
    return ground_clearance(deck_height) - TRIPOD_SAG


def forward_sign(leg, invert=False):
    return FORWARD_SIGN[leg] * (-1 if invert else 1)


# =============================================================
# REGISTERS  (STS3215 / common Feetech map)
# =============================================================
ADDR_MIN_ANGLE        = 9
ADDR_MAX_ANGLE        = 11
ADDR_TORQUE_ENABLE    = 40
ADDR_GOAL_POSITION    = 42
ADDR_GOAL_SPEED       = 46
ADDR_PRESENT_POSITION = 56
ADDR_PRESENT_TEMP     = 63
ADDR_MOVING           = 66
ADDR_PRESENT_CURRENT  = 69   # 2 bytes, bit 15 = direction

# Present-current units, from Feetech's STS3215 register table. Not yet
# checked against an ammeter on this robot -- treat totals as approximate.
AMPS_PER_COUNT = 0.0065

# One read covers 56 (position) through 70 (current): position, speed,
# load, voltage, temperature, status, moving and current in a single
# round trip, where reading them separately costs one trip each.
_STATUS_START = ADDR_PRESENT_POSITION
_STATUS_LEN = ADDR_PRESENT_CURRENT + 2 - ADDR_PRESENT_POSITION


class BusError(Exception):
    pass


# Retries. The bus is half-duplex and shared, and six servos switching
# current is an electrically noisy place, so an occasional lost reply is
# normal and not worth aborting a gait over. One lost packet used to kill
# the whole motion.
#
# But a retry that hides a real fault is worse than the abort was: a
# browning-out supply drops packets too, and that is a thing to fix, not
# to paper over. So retries are COUNTED, and callers are expected to
# report the count. A gait that completes with forty retries is telling
# you something a gait that completes with none is not.
#
# Safe for these registers specifically: goal, speed and torque writes
# are idempotent, so re-sending one the servo already applied is a no-op.
# Do not reuse this for anything that is not.
BUS_RETRIES = 2
RETRY_DELAY = 0.004      # a touch over one 1 Mbaud packet time

_retries = 0
_failures = 0


def bus_stats():
    """(retries, failures) since the last reset. Report these."""
    return _retries, _failures


def reset_bus_stats():
    global _retries, _failures
    _retries = _failures = 0


def _txrx(call, sid, what, tries=None):
    """Run a packet call, retrying a lost reply a couple of times.

    Two kinds of failure arrive here and both are retried. The SDK
    reports a lost reply as a status code, which is the ordinary case.
    But pyserial can also RAISE -- "device reports readiness to read but
    returned no data" -- and that used to escape as a traceback from
    whatever phase happened to be running, which is a poor way to find
    out that something else has the port open.
    """
    global _retries, _failures
    tries = BUS_RETRIES + 1 if tries is None else tries
    last = None
    for attempt in range(tries):
        try:
            result = call()
        except (SerialException, OSError) as e:
            last = e
        else:
            comm = result[-2] if len(result) == 3 else result[0]
            if comm == COMM_SUCCESS:
                return result
            last = comm
        if attempt + 1 < tries:
            _retries += 1
            time.sleep(RETRY_DELAY)

    _failures += 1
    if isinstance(last, Exception):
        raise BusError(
            f"servo {sid}: {what}: the serial port stopped answering "
            f"({last}). Two things do this: something ELSE has the port "
            f"open -- check `systemctl is-active crabora-agentix`, the "
            f"service and a CLI program cannot share a bus -- or the URT "
            f"re-enumerated, which a supply brownout will cause.")
    raise BusError(f"servo {sid}: {what}: {PACKET.getTxRxResult(last)} "
                   f"(after {tries} attempts)")


PACKET = None            # set on first use, for getTxRxResult


def _remember(packet):
    global PACKET
    if PACKET is None:
        PACKET = packet
    return packet


def read1(packet, port, sid, addr, what):
    _remember(packet)
    val, _comm, _err = _txrx(
        lambda: packet.read1ByteTxRx(port, sid, addr), sid, what)
    return val


def read2(packet, port, sid, addr, what):
    _remember(packet)
    val, _comm, _err = _txrx(
        lambda: packet.read2ByteTxRx(port, sid, addr), sid, what)
    return val


def write1(packet, port, sid, addr, val, what):
    _remember(packet)
    _txrx(lambda: packet.write1ByteTxRx(port, sid, addr, val), sid, what)


def write2(packet, port, sid, addr, val, what):
    _remember(packet)
    _txrx(lambda: packet.write2ByteTxRx(port, sid, addr, val), sid, what)
    if addr == ADDR_GOAL_POSITION:
        note_goal(sid, val)


def decode_current(raw):
    """Present-current register -> amps, magnitude only (bit 15 is the
    direction of the torque, not a sign worth keeping for a power budget)."""
    return (raw & 0x7FFF) * AMPS_PER_COUNT


def read_status(packet, port, sid, what="status"):
    """Position, moving flag and current in ONE round trip.

    Returns {"pos", "moving", "amps"}. Also records the current in
    LAST_CURRENT, so anything that polls servos for its own reasons
    leaves a power reading behind for agentix to show.
    """
    _remember(packet)
    data, _comm, _err = _txrx(
        lambda: packet.readTxRx(port, sid, _STATUS_START, _STATUS_LEN),
        sid, what)

    def word(addr):
        i = addr - _STATUS_START
        return data[i] | (data[i + 1] << 8)

    amps = decode_current(word(ADDR_PRESENT_CURRENT))
    note_current(sid, amps)
    return {"pos": word(ADDR_PRESENT_POSITION),
            "moving": data[ADDR_MOVING - _STATUS_START],
            "amps": amps}


# The last goal position written to each servo: {sid: (counts, when)}.
# PASSIVE -- nothing here or in any gait reads it to decide anything. It
# exists so agentix's leg animation has something to show while a motion
# holds the bus and the servos cannot be read. A goal is where the joint
# was told to go, not where it is; close during a smooth gait, wrong for
# a joint that is stalled or has been dropped limp.
LAST_GOALS = {}


def note_goal(sid, counts):
    LAST_GOALS[sid] = (counts, time.monotonic())


# The last current read from each servo: {sid: (amps, when)}. Passive,
# like LAST_GOALS: filled by read_status() as a side effect of whatever
# is polling, read by agentix's power view while a motion holds the bus.
# Readings arrive one servo at a time, so a sum of them is an estimate
# of the total draw, not a simultaneous measurement.
LAST_CURRENT = {}


def note_current(sid, amps):
    LAST_CURRENT[sid] = (amps, time.monotonic())


# =============================================================
# BUS
# =============================================================
AGENTIX_SERVICE = "crabora-agentix"


def service_holds_bus():
    """Is the agentix service running, and therefore holding the ports?

    The service keeps the URTs open for the whole time it is up -- that
    is deliberate, it is what makes the web UI answer quickly. But it
    means a CLI program started alongside it is a second reader on a
    half-duplex bus, and the symptom is not a clean error: packets
    interleave, replies land in the wrong process, and pyserial
    eventually raises in whichever one loses the race.

    Cheap to check and worth checking every time, because the failure it
    prevents costs an evening.
    """
    try:
        import subprocess
        return subprocess.run(
            ["systemctl", "is-active", "--quiet", AGENTIX_SERVICE],
            timeout=2).returncode == 0
    except Exception:          # noqa: BLE001  -- not systemd, or no systemctl
        return False


def require_bus_free(force=False):
    """REFUSE to continue while the agentix service holds the ports.

    This used to be a warning you could answer past, and it was answered
    past three times running -- every time producing a corrupted move and
    a robot left part-way through a sequence. A warning that is always
    ignored and always followed by failure should not be a warning.

    Worth being explicit about, because it is genuinely confusing: the
    SERVICE holds the serial ports whether or not the chat agent is
    enabled. The arbiter opens all three URTs at startup and keeps them
    open -- that is what makes the UI answer quickly. So a UI showing
    "no agent" because there is no API key is still a process that owns
    the bus. "The agent is not running" and "the service is not running"
    are different statements.

    Returns True if it stopped the caller; the caller should exit.
    """
    if not service_holds_bus():
        return False
    print(f"\n  REFUSING TO START: {AGENTIX_SERVICE} is running and holds "
          f"the servo ports.")
    print()
    print(f"    This is true even if the web UI says \"no agent\" -- the")
    print(f"    service opens the bus at startup and keeps it open, with or")
    print(f"    without an API key. Two readers on a half-duplex bus")
    print(f"    interleave their packets and the loser fails partway through")
    print(f"    a move, which is how a robot gets left mid-sequence.")
    print()
    print(f"        sudo systemctl stop {AGENTIX_SERVICE}")
    print(f"        <run this program>")
    print(f"        sudo systemctl start {AGENTIX_SERVICE}")
    print()
    if force:
        print("  --force given: continuing anyway. Expect bus errors.\n")
        return False
    print("  (--force overrides this, but it has never once worked.)\n")
    return True


def open_ports(devices):
    """Open each URT at the bus baud rate. Returns {device: PortHandler}."""
    ports = {}
    for device in devices:
        port = PortHandler(device)
        port.baudrate = DEFAULT_BAUDRATE
        try:
            if port.openPort():
                ports[device] = port
            else:
                print(f"  {device}: failed to open")
        except Exception as e:  # pyserial raises on permissions, busy port, etc.
            print(f"  {device}: failed to open ({e})")
    return ports


def find_joints(packet, ports, legs, joint=COXA_JOINT_DIGIT, quiet=False):
    """Ping one joint of each leg on every open port. Returns {leg: (sid, port)}."""
    found = {}
    name = JOINT_NAME[joint]
    for leg in legs:
        sid = leg * 10 + joint
        for device, port in ports.items():
            _model, comm, _err = packet.ping(port, sid)
            if comm == COMM_SUCCESS:
                found[leg] = (sid, port)
                if not quiet:
                    print(f"  leg {leg} {name} (servo {sid}): found on {device}")
                break
        else:
            if not quiet:
                print(f"  leg {leg} {name} (servo {sid}): no answer")
    return found


def find_coxas(packet, ports, legs, quiet=False):
    """Back-compat wrapper: find_joints() restricted to the coxas."""
    return find_joints(packet, ports, legs, COXA_JOINT_DIGIT, quiet)


def read_limits(packet, coxas, verbose=True):
    """Read each joint's firmware angle limits. Returns {leg: (lo, hi)}.

    Raises BusError if a joint has no usable travel around centre -- that
    means set_center.py hasn't been run on it, and nothing should move.
    """
    limits = {}
    for leg, (sid, port) in sorted(coxas.items()):
        lo = read2(packet, port, sid, ADDR_MIN_ANGLE, "read min limit")
        hi = read2(packet, port, sid, ADDR_MAX_ANGLE, "read max limit")
        if verbose:
            print(f"  leg {leg} limits {lo}..{hi}  "
                  f"({to_degrees(lo):+.1f}° .. {to_degrees(hi):+.1f}°)")
        if lo >= hi or not lo <= CENTER_POSITION <= hi:
            raise BusError(
                f"leg {leg} has no usable travel around centre ({lo}..{hi}) -- "
                f"run utils/set_center.py on servo {sid} first")
        limits[leg] = (lo, hi)
    return limits


def arm(packet, coxas, speed):
    """Set move speed and enable torque on every coxa."""
    for leg, (sid, port) in coxas.items():
        write2(packet, port, sid, ADDR_GOAL_SPEED, speed, "write speed")
        write1(packet, port, sid, ADDR_TORQUE_ENABLE, 1, "enable torque")


def release(packet, coxas):
    """Drop torque on every coxa. Best effort -- never raises."""
    for leg, (sid, port) in coxas.items():
        try:
            write1(packet, port, sid, ADDR_TORQUE_ENABLE, 0, "release torque")
        except BusError as e:
            print(f"    could not release leg {leg}: {e}")


def move_all(packet, coxas, targets):
    """Send every coxa to its own target and wait for all to arrive.
    Returns {leg: (position, timed_out)}."""
    for leg, (sid, port) in coxas.items():
        write2(packet, port, sid, ADDR_GOAL_POSITION, targets[leg], "write goal")

    deadline = time.monotonic() + MOVE_TIMEOUT
    time.sleep(0.05)  # let the servos start moving before polling
    results = {}
    pending = set(coxas)
    while pending:
        for leg in list(pending):
            sid, port = coxas[leg]
            pos = read2(packet, port, sid, ADDR_PRESENT_POSITION, "read position")
            moving = read1(packet, port, sid, ADDR_MOVING, "read moving flag")
            results[leg] = (pos, False)
            if not moving and abs(pos - targets[leg]) <= POSITION_TOLERANCE:
                pending.discard(leg)
        if pending and time.monotonic() > deadline:
            for leg in pending:
                results[leg] = (results[leg][0], True)
            break
        if pending:
            time.sleep(0.02)
    return results


def clamp_targets(targets, limits):
    """Clip each target to its servo's firmware limits.
    Returns (clamped_targets, [(leg, wanted, got), ...])."""
    out, clamped = {}, []
    for leg, want in targets.items():
        lo, hi = limits[leg]
        got = max(lo, min(hi, want))
        if got != want:
            clamped.append((leg, want, got))
        out[leg] = got
    return out, clamped


def report(coxas, targets, results, tolerance=POSITION_TOLERANCE):
    """Print measured vs commanded per leg. Returns (all_arrived, trouble)."""
    print(f"\n    {'leg':>3} {'servo':>5} {'name':<12} {'target':>7} "
          f"{'actual':>7} {'err':>5} {'angle':>8}")
    ok, trouble = True, {}
    for leg in sorted(coxas):
        sid, _port = coxas[leg]
        pos, timed_out = results[leg]
        err = pos - targets[leg]
        flag = ""
        if timed_out:
            ok = False
            trouble[leg] = "stalled"
            flag = "  ⚠ STALLED"
        elif abs(err) > tolerance:
            ok = False
            trouble[leg] = "off target"
            flag = "  ⚠ off target"
        print(f"    {leg:>3} {sid:>5} {LEG_NAME[leg]:<12} {targets[leg]:>7} "
              f"{pos:>7} {err:>+5} {to_degrees(pos):>+7.1f}°{flag}")
    return ok, trouble


def check(targets, results, tolerance=POSITION_TOLERANCE):
    """Quiet version of report(): returns (all_arrived, {leg: reason})."""
    ok, trouble = True, {}
    for leg, (pos, timed_out) in results.items():
        if timed_out:
            ok, trouble[leg] = False, "stalled"
        elif abs(pos - targets[leg]) > tolerance:
            ok, trouble[leg] = False, "off target"
    return ok, trouble


# =============================================================
# OPERATOR
# =============================================================
def confirm(question):
    """Explicit 'y' to continue. Anything else -- a bare Enter, Ctrl-C,
    closed stdin -- aborts, so the reflexive response is the safe one."""
    try:
        answer = input(f"\n  {question} [y/N] ").strip().lower()
    except (EOFError, KeyboardInterrupt):
        print()
        return False
    return answer == "y"
