downTheFallLine/crabora/software/stand2.py

"""
CRABORA: stand2 -- geometric stand, two tripods at a time
=========================================================

The simple, no-poses-file stand: every joint goes to a computed target
instead of a hand-taught one.

  coxa  (x1)  ->  center            (2048)
  femur (x2)  ->  +45 deg off center (2560)
  tibia (x3)  ->  +90 deg off center (3072)

Sign convention verified against the hand-taught 'stand' pose (poses.json):
positive counts = joint extends to stand.  The first cut used -45/-90 and
stood the bot "on its back".

Legs are discovered at runtime across every URT (see MultiBus), then moved
as two alternating tripods -- odd-numbered legs first, then even-numbered --
so only half the servos draw current at once (5 A bench-supply budget).
Torque comes on for ALL servos before anything moves, so the waiting tripod
holds its pose instead of sagging.

Every discovered leg must be complete (coxa/femur/tibia); targets are
clamped to each servo's firmware angle limits, with a warning when that
happens.  Ends HOLDING the stance (torque on); pass --release to relax.

Requirements (every servo): position mode (wheel_off.py), angle limits
(set_limits.py), center calibrated (set_middle.py) -- the targets are
absolute counts around 2048, so an uncalibrated center stands crooked.

Usage:
  python stand2.py                # both tripods, pausing between them
  python stand2.py --speed 4      # slower
  python stand2.py --no-pause     # don't wait for Enter between tripods
  python stand2.py --release      # relax after standing (default: hold)
"""

import argparse
import sys

from crabora_bus import (
    MultiBus,
    ADDR_MIN_ANGLE, ADDR_MAX_ANGLE, ADDR_MODE, ADDR_PRESENT_POSITION,
    MODE_POSITION, MODE_NAMES,
    COUNTS_PER_REV, DEGREES_PER_REV, CENTER_POSITION, MAX_POSITION,
    TYPICAL_MAX_RPM,
    COXA, FEMUR, TIBIA, JOINT_NAMES, joint_of,
    TRIPOD_A, TRIPOD_B,
    describe_id, rpm_to_pos_speed,
)

# -----------------------------------------------------------------------------
# Joint targets, in degrees off center (positive = higher counts = extend
# to stand; matches the hand-taught 'stand' pose, which averages femur +34
# tibia +42 across all six legs).
JOINT_TARGET_DEG = {COXA: 0.0, FEMUR: 45.0, TIBIA: 90.0}

SPEED_RPM = 6.0    # slow: this is the load-bearing move


def deg_to_counts(deg):
    """Absolute position counts for an angle in degrees off center."""
    return CENTER_POSITION + round(deg / DEGREES_PER_REV * COUNTS_PER_REV)


def parse_args():
    p = argparse.ArgumentParser(
        description="Geometric stand: coxa center, femur -45 deg, tibia "
                    "-90 deg, moved as two alternating tripods.",
        formatter_class=argparse.RawDescriptionHelpFormatter)
    p.add_argument("--speed", type=float, default=SPEED_RPM,
                   help=f"move speed in RPM (default {SPEED_RPM:g})")
    p.add_argument("--no-pause", action="store_true",
                   help="don't wait for Enter between tripods")
    p.add_argument("--release", action="store_true",
                   help="relax after standing (default: hold)")
    p.add_argument("--yes", action="store_true",
                   help="skip the initial confirmation")
    return p.parse_args()


def preflight(bus, servo_id):
    """Position-mode + angle-limit check. Exits on failure -> (min, max)."""
    label = describe_id(servo_id)
    mode = bus.read_uint8(servo_id, ADDR_MODE)
    if mode != MODE_POSITION:
        print(f"✗ {label} (ID {servo_id}) in {MODE_NAMES.get(mode, mode)} mode; "
              f"needs position mode.  Run: python wheel_off.py {servo_id}")
        sys.exit(1)
    mn = bus.read_uint16(servo_id, ADDR_MIN_ANGLE)
    mx = bus.read_uint16(servo_id, ADDR_MAX_ANGLE)
    if mn >= mx or (mn == 0 and mx >= MAX_POSITION):
        print(f"✗ {label} (ID {servo_id}) has no usable angle limits ({mn}..{mx}). "
              f"Run: python set_limits.py {servo_id}")
        sys.exit(1)
    return mn, mx


def clamp(servo_id, counts, limits):
    mn, mx = limits[servo_id]
    c = max(mn, min(mx, counts))
    if c != counts:
        print(f"  ⚠  {describe_id(servo_id)} target {counts} clamped to {c} "
              f"({mn}..{mx})")
    return c


def maybe_pause(msg, do_pause):
    if do_pause:
        try:
            input(f"\n{msg}  [Enter to continue, Ctrl+C to abort] ")
        except EOFError:
            pass
    else:
        print(f"\n{msg}")
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
