downTheFallLine/crabora/software/tripod_walk.py

"""
CRABORA: tripod_walk -- first walking gait, alternating tripods
===============================================================

The classic hexapod gait: legs split into two tripods that take turns
being planted (stable, propelling) and swinging (in the air, reaching
forward).  One tripod is always on the ground, so the bot is statically
stable at every instant -- no balance code.

Leg layout (top view, CLOCKWISE from the front): 1, 6, 3, 5, 2, 4
  Tripod A = legs 1, 3, 2        Tripod B = legs 6, 5, 4

Half-cycle, with S = swing tripod and T = stance tripod:
  1. LIFT   S femurs rise LIFT_DEG          -- S feet leave the ground
  2. SWING  S coxas rotate to their forward pose while T coxas sweep to
            their backward pose             -- T pushes: the bot MOVES here
  3. PLANT  S femurs return to stance       -- S feet down
Then S and T swap.  One full cycle = both tripods have stepped.

Straight-line travel with radially-mounted legs: each leg's coxa swing is
scaled by sin(bearing - heading).  Side legs push hardest; legs pointing
along the travel direction lift and replant in place.  --heading 0 walks
toward leg 1 (the front); --heading 90 crab-walks toward the leg-3 side.

DIRECTION UNVERIFIED: the coxa +count rotation sense (CW vs CCW from the
top) hasn't been established on hardware.  If the first try walks
backward, add --reverse -- then we hardcode the flip and delete the flag.

Stance matches stand2.py (coxa center, femur +45, tibia +90).  The script
moves to that stance first (one tripod at a time, 5 A budget), walks, then
recenters the coxas and HOLDS.  Tibias never move during the gait.
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
