downTheFallLine/crabora/(commit log)

2026-07-21 add logic to move servo to degrees
2026-09-22 Reorganize software into software.old/ + new software/ tree, add bring-up test suite
    Moved all flat bench scripts (including the servo tooling pulled from
    origin) into software.old/ for reference, and started a fresh software/
    tree for the onboard-Pi build: urt_lib.py ported forward unchanged, plus
    software/tests/ with the first two bring-up tests (Pi stability burn-in,
    FE-URT-2 USB visibility). Added doc/bringUp.md as the full test-sequence
    checklist, plus doc/servoNotes.md, doc/uniBody.md, leg/, standOffs/,
    unibody/, and shims/ which had never been committed. Added .gitignore
    for __pycache__/.DS_Store and dropped the copies of those that had
    previously been committed by mistake.
    Co-Author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
    [Crabora Engineering Change Orders.xlsx, brace.stl, coxa_body_cap.stl, coxa_body_mount.stl, coxa_cap.stl, coxa_cap_shim.stl, coxa_pan.stl, femur_cap.stl]
2026-09-26 new util to read a servo
2026-09-26 add sweep servo
2026-09-29 Tighten coxa body cap pocket, widen cable slot; add go_limp util
    - coxa body cap: shrink pocket width 0.8mm and depth 1.9mm, absorbed
    by thicker ±Y walls so the M3 bolt hole positions don't move
    - widen cable pass-through slot to span the full pocket width and
    extend it 10mm longer along X
    - add utils/go_limp.py to release torque on a servo by ID
    [coxa_body_cap.stl]
2026-09-29 Remove obsolete v1 coxa cap, add swing_arm leg exerciser
    - drop design_coxa_cap.py + coxa_cap.stl (v1 sandwich-mount design,
    superseded by design_coxa_body_cap.py)
    - add utils/swing_arm.py to sweep all three joints (coxa/femur/tibia)
    of one leg through their full range, given a leg number 1-6
    [coxa_cap.stl]
2026-09-29 Add --mode together to swing_arm.py
    Lets all three joints of a leg sweep in lockstep (center/right/left/
    center together) instead of one at a time; sequential stays the default.
2026-10-06 Add swing_legs.py: exercise N legs at once
    Sweeps every joint of each listed leg with together, by-joint and
    sequential modes; opens each serial port once and shares it.
2026-10-06 Add test_03_ping_servo.py: ping servos by ID across URTs
    Pings each requested ID on every FE-URT-2 board; fails on no answer or
    an ID answering on more than one board.
    [test_03_ping_servo.py]
2026-10-06 add go limp for all servo script
2026-10-06 synch up
    [femur_cap.stl, horn_spacer.10.5mm.stl, horn_spacer.12.5mm.stl, horn_spacer.6.6.stl, horn_spacer.6.6mm.stl, horn_spacer.8.5mm.stl, horn_spacer.stl.10mm.stl, horn_spacer.stl.6mm.stl]
2026-10-06 Tidy coxa sweep stall output
    Print each rep's stall warnings after the rep line instead of
    interleaving them with the right/left labels.
    [test_04_coxa_sweep.py]
2026-10-09 Add parametric board sled for the buck converter and URT
    One script with --board presets: slab + 5mm standoffs on the board's
    own hole pattern. Dimensions measured off the actual boards -- buck is
    the larger 66x36 LM2596 variant, URT 56.5x36.5. URT screw size assumed
    1.8mm and flagged at build time.
    [buck_sled.stl, urt_sled.stl]
2026-10-09 Add flanged unibody deck design
    Bolted flanged pieces replacing the glued-up hex deck, which failed at
    the glue joints. Drops the abandoned carbon-fibre deck line.
    [deck_assembly.stl, deck_hub.stl, deck_mid.stl, deck_outer.stl]
2026-10-10 Refine sled hole specs from measured boards
    URT: spans re-measured across M3 shanks (48.5 x 28.5 c2c, a uniform
    4mm corner inset), Phi2.2 pilots for M3 wood screws, posts up to Phi8
    so the wood screw doesn't split them. Buck: Phi2.0 holes. Standoff
    diameter is now per-board, and hole spans are stored outright rather
    than derived from one inset.
    [buck_sled.stl, urt_sled.stl]
2026-10-10 Buck sled: Phi2.2 holes, spans re-measured
    Holes up 0.2mm to Phi2.2 (clearance for the 1.8mm screw, so nuts under
    the slab). Centres from measured 64 x 34 mm outside-to-outside across
    the Phi2.2 board holes = 61.8 x 31.8 c2c, a uniform 2.1mm inset.
    [buck_sled.stl]
2026-10-10 Start fresh walk tree: conventions README + coxa proto-walk
    Delete the previous generation of gait/stand/pose code from
    software.old (recoverable from history).
    software/walk/README.md fixes the conventions everything here depends
    on: front is the hexagon point between legs 1 and 6, legs numbered
    clockwise from above at 30 + (n-1)*60 degrees, body frame +X forward
    /+Y left/+Z up, tripods 1-3-5 and 2-4-6, and the left/right mirror
    that makes a positive coxa command swing the two sides opposite ways.
    proto_walk_coxa.py is the first locomotion-shaped motion: centre,
    confirm, sweep forward, confirm, sweep rear, confirm, recentre, limp.
    Forward/rear signs are derived from leg bearing (foot move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
    [new_stand.py, proto_walk_coxa.py, stand.py, stand2.py, stand_degrees.py, take_step.py, teach_pose.py, tripod_walk.py]
2026-10-10 proto_walk_coxa: add --reps for continuous runs
    --reps N runs N forward/rear cycles with no pause between stages,
    reporting one compact line per rep and accumulating per-leg stalls and
    off-target moves into an end-of-run summary. The centring confirm still
    gates the start; --no-pause drops that too for fully unattended runs.
    Default single-rep behaviour is unchanged.
    [proto_walk_coxa.py]
2026-10-10 Add tripod gait for coxas, extract shared gait_lib
    tripod_coxa.py runs the alternating tripod on the coxas only: tripod A
    (1,3,5) and B (2,4,6) always opposed, swapping each half-stride, --reps
    full strides per run. --dry-run prints body-frame direction beside the
    raw counts, since the counts differ between mirrored sides and only the
    directions should be judged by eye. Also --reverse and --dwell.
    gait_lib.py now holds the geometry constants, FORWARD_SIGN and the bus
    plumbing, so 'which way is forward' is defined in exactly one place;
    proto_walk_coxa.py is refactored onto it.
    No lift without the femurs, so this is a test-stand exercise -- Crabora
    hangs with its legs in mid air, which is al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
    [gait_lib.py, proto_walk_coxa.py, tripod_coxa.py]
2026-10-10 Coxa forward sign verified on hardware
    All six coxas driven by tripod_coxa.py on the test stand, tripods
    opposing as intended, no --invert needed. FORWARD_SIGN is correct as
    written and the mirror is real. Strip the UNVERIFIED warnings; --invert
    is now a diagnostic rather than a suspected fix.
    [gait_lib.py, proto_walk_coxa.py]
2026-10-11 Add femur proto-walk, generalise gait_lib to any joint
    proto_walk_femur.py mirrors proto_walk_coxa.py for the femurs: centre
    (horizontal) -> up -> down -> centre, with operator confirms or --reps
    for continuous runs.
    gait_lib gains joint digit constants (coxa 1, femur 2, tibia 3) and
    find_joints(), so the tibia script will be short. FEMUR_UP_SIGN is +1
    for all six on the reasoning that lift is the same physical motion on
    every leg -- unlike the coxa, whose mirror comes from body geometry.
    PREDICTED, not measured: --legs 1 4 is the run that settles it.
    README records the femur decisions: centre = horizontal, envelope +/-90,
    why horizontal over stance-pose, and that the useful range is asymm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
    [gait_lib.py, proto_walk_femur.py]
2026-10-11 Resolve design script output paths from the script location
    Every design script in leg/ used a relative OUT_DIR of 'linkage_leg',
    so output landed wherever the script happened to be run from. That had
    already gone wrong: tibia_cap.stl and others sat at leg/<part>/ while
    newer runs wrote to leg/<part>/linkage_leg/, leaving duplicate tracked
    copies at two paths.
    Now matches spacer/, sled/ and unibody/: OUT_DIR is derived from
    __file__, so output always lands beside the design file. Regenerated
    every part from an unrelated cwd to confirm, and removed the stale
    duplicates at the old paths -- 12 of 14 were byte-identical, and the
    coxa_body_cap pair at the old path was stale.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
2026-10-11 Add requirements-cad.txt for the part-generation scripts
    Pins what the design_*/assembly_*/generate_* scripts actually need.
    Notably manifold3d, scipy and networkx: trimesh does not pull these in
    and they only fail at call time, so a fresh checkout dies on the first
    boolean with a confusing ImportError. Kept separate from
    software/requirements.txt, which is the Pi runtime and needs none of it.
2026-10-11 Fix femur up/down sign: rising count lowers the joint
    Hardware run 2026-10-11 showed the femurs moving opposite to the
    labels -- the script asked 'did every femur rise?' after lowering them.
    FEMUR_UP_SIGN is -1, not +1.
    The run did confirm the part that mattered: all six moved together, so
    the femurs are NOT mirrored like the coxas, and one sign serves every
    leg as predicted. Only the direction was wrong.
2026-10-11 Add tibia proto-walk; tibia centre is collinear with the femur
    Centre 2048 = leg dead straight, zero knee bend. Chosen for repeatable
    calibration: a straight leg presses against a straightedge, whereas a
    right angle is eyeballed six times and mismatched legs limp. Also makes
    tibia angle = flexion from straight for later IK.
    A knee bends one way, so centre is the EDGE of travel, not the middle.
    proto_walk_tibia.py therefore takes separate --extend and --flex angles
    rather than one symmetric --angle, which would clamp against the extend
    limit on every leg every rep.
    TIBIA_EXTEND_SIGN is +1 as a first guess and is the last unverified
    joint sign. Expect it uniform across all six (knees are not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
2026-10-11 Add tripod gait with coxa and femur
    First script with the real shape of a walking gait: the femur supplies
    the lift the coxa-only version could not. One stride is two half-strides
    of three moves each -- lift the swinging tripod, swing it forward while
    the stance tripod drives rear, plant it.
    Each move touches one joint type only, so at most six servos start
    together, not twelve. Legs answering on only one joint are excluded
    rather than half-driven. Failures are tagged with the phase they
    happened on, so a stall points at lift/swing/plant rather than just the
    leg. The dry run prints body-frame directions beside the tripod
    grouping, since raw counts differ between mirrored sides.
    Stance femu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
2026-10-11 Record confirmed link geometry
    Link lengths read from CAD and confirmed against the built leg with
    calipers: body->coxa axis 163.22, coxa->femur 58 radial / 21 tangent /
    17.6 vertical, femur 100, tibia 120. All axis-to-axis.
    Notable: the femur axis is displaced 21mm sideways from the coxa axis,
    so the leg is NOT a planar 2-link chain on a yaw joint. IK written
    against the textbook model would be wrong by an amount that looks like
    calibration drift. Flagged in both gait_lib and the README.
    Corrects a stale README note claiming 58/100/120 predated the current
    leg revision -- the CAD still says exactly those. Also marks travel
    limits as set.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
2026-10-11 Add software/stand: recovery strategy and phase-0 survey
    survey.py reads all 18 joints without moving anything -- position,
    travel limits, load, temperature, latched errors -- and computes each
    foot's position in the body frame by forward kinematics.
    Finding worth recording: a leg CANNOT fold under the deck. The knee sits
    at radius 222mm, outside the deck's 210mm circumradius, so nothing
    distal to it reaches underneath; the most folded pose still leaves the
    foot ~21mm clear of the deck edge. The real tangle risk is leg against
    NEIGHBOUR, so the survey checks adjacent foot separation instead.
    Tibia sign is flagged TBD/ASSUMED throughout, per Tom 2026-10-11 --
    notably it gates step 1 of the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
2026-10-11 Add leg IK and named stand poses
    pose.py: two-link IK in the leg's vertical plane, its inverse, and the
    poses the recovery moves between -- splay (every joint at centre, which
    by construction is the belly-down resting splay), compact (drawn in and
    lifted, for swinging past neighbours), tuck, and stand at a given deck
    height.
    Poses are specified as foot POSITIONS and solved, not written as joint
    angles. Picking angles by eye gets the vertical wrong: femur +35 with
    90 of flex looks lifted but puts the foot on the floor, because flexion
    bends the foot down from the femur. Asking for the foot above the femur
    axis needs femur near +88, at the edge of the envelope; clearing the
    floor by 30mm need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
2026-10-11 Add the stand recovery program
    Four phases: survey (read-only, refuses to continue past a latched
    overload), collapse (femurs horizontal and tibias straight so the body
    settles belly-down, coxas deliberately untouched), untangle (one leg at
    a time: compact, rotate coxa, set down), stand (all legs together,
    interpolated from tuck in steps).
    Safety layers: firmware travel limits clamp every target; a preflight
    check names any joint that would clamp BEFORE moving, since the
    recovery poses need far more travel than a gait; torque limited to 35%
    during recovery and 85% for the lift, with every write read back so an
    unconfirmed cap is reported rather than believed; bind detection from
    load with n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
2026-10-11 Raise the untangle lift; make it tunable
    On hardware the compact pose did not lift the femur enough for a leg to
    swing cleanly. Ground clearance default 30 -> 70 mm, which at out=140
    moves the femur from +52 to +67 and puts the foot 27mm above the femur
    axis instead of 13 below.
    Exposed as --compact-clear and --compact-out rather than baked in, since
    the right value depends on what the leg is actually catching on, and
    the preflight check will flag it if the femur limits cannot reach.
2026-10-11 Fix the floor strike that broke a tibia
    Root cause: COLLAPSE lowered femurs to horizontal while tibias were
    still flexed. With the floor 62.6mm below the femur axis, as little as
    40 degrees of residual flex puts the foot underground; the servo then
    pushes until something breaks. Tibia 5 snapped.
    Three fixes:
    1. Ground model corrected. BELLY_DROP was inferred from the deck flange
    depth at 25mm; Tom measured the coxa horn at 45mm above the floor, so
    the floor is 20mm further down than modelled and every computed
    clearance was optimistic.
    2. COLLAPSE reordered: raise every femur to at least 45 degrees first
    (reading each one so it only ever raises), straighten tibias while
    the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
2026-10-11 Tibia link v3: rounded foot, solid body
    Rounded tip replaces the flat squared edge, which caught on the floor
    hard enough to snap a tibia. A round foot presents a tangent to the
    ground through the whole swing instead of a corner, so the leg skids
    rather than digging in.
    Built as the convex hull of the knee disc and a foot circle, which
    gives both tangent flanks and both arcs exactly with no tangent
    trigonometry to get wrong. The tip stays at X=LINK_LEN, so TIBIA_LEN
    120 in walk/gait_lib.py is still knee-axis-to-foot-tip and the
    kinematics are unchanged.
    Truss disabled (N_TRUSS 0). The open triangles removed material from
    mid-span, which is exactly where bending stress peaks. Solid costs
    3.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
2026-10-11 Stop untangle dragging legs across the floor
    Two faults, both of which ended with a foot ploughing the ground.
    1. Untangle finished in a "tuck" pose with only 10mm of modelled floor
    clearance -- no margin for an uneven floor or any error in the ground
    model. Legs are now LEFT LIFTED (70mm clear) and the foot descends
    only during the stand phase, which is slow and interpolated. The
    stand consequently starts from the lifted pose rather than tuck.
    2. Worse: if a femur's travel limits could not reach the requested lift,
    the pose silently clamped and the coxa rotated anyway, dragging the
    low-hanging foot. A femur capped at +30 leaves the foot ~1mm BELOW
    the floor while the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
2026-10-11 Report travel limits in --phase survey
    The survey phase returned before limits were ever read, so the one
    command you reach for to ask "can this even work?" showed nothing about
    the thing most likely to stop it. Limits are now read before that early
    return and printed as a per-leg table, with an explicit warning naming
    any joint that cannot reach the recovery poses and the angle it needs.
2026-10-11 Recalibrate bind thresholds against a real run
    A femur holding an outstretched leg against gravity settles 2-5 degrees
    short at 18-43% load. That is ordinary servo droop under a cantilever,
    not a bind, but the thresholds called all of it a fault: 21 counts
    "failed" a 20-count tolerance by one count, and 30% load counted as
    bound against an 85% torque limit.
    BIND_LOAD 300 -> 600 counts (60% of scale)
    loaded tolerance 20 -> 60 counts (~5 deg), used in the stand phase
    where joints are holding weight; the tighter
    free-movement tolerance still applies elsewhere
    The stand phase now prints worst sag per step, so droop is visible
    rath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
2026-10-11 Let loaded phases use their own arrival tolerance
    move_group still judged arrival by the tight free-movement tolerance,
    so a femur settling 30 counts short under body weight never satisfied
    it, waited out the full timeout and was reported as stalled. The
    loosened check added earlier ran only AFTER that, so it never had a
    chance -- a healthy six-leg stand reported 0 of 6.
    move_group now takes a tolerance and the stand phase passes
    LOADED_TOLERANCE. Sag within tolerance passes and is reported as sag; a
    genuinely stuck joint still fails, verified both ways against a
    simulated bus.
    For the record, the run this came from was a success: with all six legs
    sharing load, peak sag halved (76 -> 37 c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
2026-10-11 Add dance
    Five moves built on the same leg IK as the stand:
    bob body rises and falls, feet planted
    twist every coxa the same way at once, so the feet stay put and the
    BODY yaws about its centre
    bounce tripod A extends while B retracts, rocking the body; still a
    tilt, not a step
    wave each leg lifts and sets down in turn around the hexagon,
    exactly one foot up at a time
    shimmy tripods swing their coxas opposite ways, twisting fast
    Assumes the robot is already standing: it settles into the standing
    pose first and refuses to dance if it cannot reach it, pointing at
    stand.py. Ctrl-C returns to standing rather than dropping torque, since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
2026-10-11 Add dance_forever.sh
    Loops dance.py until interrupted. Arguments pass straight through.
    Ctrl-C stops the loop cleanly: the running dance.py gets the same
    signal and parks the robot at its standing pose first, so it does not
    go limp and drop. The script recognises dance.py's 130 exit as exactly
    that and stops quietly, and bails on any other non-zero rather than
    hammering a robot that is already unhappy.
    Prints a cycle count and elapsed time on the way out.
2026-10-11 Add turn: rotate in place, clockwise
    Turns 90, 180, 270 or 360 degrees on the spot, always to the right.
    Tripod gait: lift the swing tripod, sweep the stance coxas to push the
    body round, plant, alternate.
    Two things make a turn different from a walk, and both are easy to get
    wrong:
    1. No left/right mirror. Walking forward needs the two sides opposite
    because "forward" points differently per leg; a turn is a pure
    rotation, so every coxa goes the same way with no per-side sign.
    2. The body turns about HALF as far as the coxa does. The hip is 163mm
    out from the body centre and the foot 178mm beyond it, so a planted
    leg swinging its coxa by a turns the body by
    atan2(d sin a, R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
2026-10-12 Fix turn losing two thirds of its rotation
    The lift phase swept the swing leg's coxa from +a to -a at the same
    time as raising the femur. The foot is still on the floor for the first
    part of that move, so it dragged and pulled the body back round,
    cancelling most of what the stance tripod had just gained. Commanding
    180 produced about 60.
    Phases are now properly separated:
    LIFT femur only, coxas held exactly where they are
    SWEEP stance pushes -a -> +a; swing resets, safely in the air
    PLANT femur down, coxas held
    Also adds --efficiency for the slip that remains. Planted feet scrub
    and scrub is slip, so the real turn always falls short of the geometric
    one; the flag scales the step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
2026-10-12 Turn: hold the feet planted instead of scrubbing them
    The coxa-only turn forced every planted foot to slide ~3.9mm radially
    on each sweep, because a leg with fixed femur and tibia traces an arc
    about its own hip, not about the body centre. A foot sliding radially
    has no tangential grip either, so most of the push was lost: 90
    commanded gave 30-45.
    The sweep now re-solves femur and tibia at every interpolated point so
    each stance foot stays on the SAME patch of floor while the body
    rotates about it. The leg reaches further round to do it -- 178mm at
    neutral out to 196mm at 20 degrees of body rotation. Verified: foot
    radius holds to 0.0000mm across the sweep, against 3.9mm before.
    Side effec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
2026-10-12 Tibia link v4: ribbed spine for lateral strength
    Tibias were snapping near the knee on carpet during turns. That is the
    cantilever root -- peak bending moment -- and the load is LATERAL,
    perpendicular to the plate face, which is the one direction a flat 5mm
    plate is hopeless in.
    A rib down the centreline makes it a T-beam. At a 20mm-wide station:
    5 mm flat plate Z = 83 mm^3 1.0x
    8 mm flat plate Z = 213 mm^3 2.6x +60% material
    5 mm plate + 5x12 rib Z = 322 mm^3 3.9x +60% material
    Same mass, half again the strength, so a rib rather than a thicker
    plate. PLA only, so this had to be won geometrically.
    The rib starts at X=17, just clear of the Ph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
2026-10-12 Emboss DACTYL / BLOCK 4 on the tibia
    DACTYL is the terminal segment of an arthropod leg -- coxa, basis,
    ischium, merus, carpus, propodus, dactylus -- so it is the
    anatomically correct name for the part that actually touches the
    ground, and it suits a crab-shaped robot.
    Raised 0.6mm on the flat -Z face, opposite the spine. Glyphs come from
    matplotlib TextPath; the even-odd rule is applied by symmetric
    difference so counters in A, B, C, O, D stay open rather than filling
    solid.
    Three things that had to be got right, each of which failed first time:
    - the letters must SINK slightly into the face (MARK_EMBED 0.2mm).
    Merely touching leaves coincident faces that booleans resolve
    badly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
2026-10-12 Engrave the marking beside the rib instead of raising it
    Three corrections:
    - ENGRAVED 0.6mm into the face, not standing proud of it
    - on the +Z face, the same side as the rib, not the opposite one
    - offset to one side of the rib rather than down the centreline
    The band beside the rib is narrow and tapers -- about 11.6mm at the
    knee down to 6.8mm by X=70 -- so the text is smaller (5.5 / 4.0 rather
    than 9 / 5) and starts at X=22 where the part is widest. Rows stack
    outward from the rib, with the block laid down first so the name ends
    up on top.
    Each cutter stands 0.2mm proud before cutting down 0.6mm: starting
    exactly level with the surface shares a face with the body, which
    booleans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
2026-10-12 Femur link v2: ribbed spine
    Same treatment as the tibia, and for the same reason: it is a flat 5mm
    plate loaded laterally, with a LONGER moment arm than the tibia since
    the load acts at the foot through the whole leg. Strengthening the
    tibia moves the weak point here.
    flat 24 x 5 beam Z = 100 mm^3 1.0x
    + 5 x 12 mm rib (T-section) Z = 331 mm^3 3.3x for +50% material
    Costs 2.1 cm3, about 2.6 g per leg and 15 g over six.
    The rib runs X=18..61, ramping to full height by 26 so it is strongest
    at the HIP end where the cantilever moment peaks.
    Caught while checking: the knee plate is centred 12.5 mm INBOARD of the
    tibia axis, not outboard, so it starts at X=61.4 rather than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
2026-10-12 Add test 5: calibration consistency
    Answers one question -- are all 18 joints set up the same way as each
    other? None of the faults this catches are visible from a single joint;
    they only show up with the six legs side by side.
    Written because the same class of fault kept costing time: leg 6 carried
    different travel limits from every other leg for several sessions before
    anyone noticed, centres were set to a convention that then changed, and
    the tibia direction sign is still assumed rather than measured despite
    gating every phase of the stand recovery.
    Three passes:
    SURVEY (default, read-only) compares each joint's travel limits
    against the median of its peers and flags outliers, chec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
2026-10-12 Add test 6: MPU-6050 IMU
    Checks the IMU is wired, talking, and -- the part that matters --
    mounted the right way round.
    A sensor that answers on the bus but sits rotated 90 degrees on the
    deck passes every naive test and then quietly corrupts every heading
    the robot computes. So the test uses gravity as a known reference: the
    robot is still on a level floor, so the accelerometer must read ~1 g
    down the body frame's -Z and ~0 on X and Y. Anything else is a rotated
    mount, and it says which way:
    gravity on +Z -> upside down
    gravity on -Y or -X -> on its side or end, with the fix
    -Z but X/Y non-zero -> tilted, and by how much
    Also catches: no I2C bus (with the Ubuntu-spec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
2026-10-12 Add IMU calibration and heading
    imu_lib.py wraps the MPU-6050 in the three things that make it usable:
    - GYRO RE-ZERO AT STARTUP, not stored. Bias moves with temperature, so
    a figure saved last week is wrong once the servos have warmed the
    deck. zero_gyro() measures it fresh and refuses if the robot was
    moving -- a bias measured while moving is worse than none, because
    it is then subtracted from every future reading. Two separate
    checks, because the two kinds of motion look nothing alike: wobble
    shows up as variance, a steady turn does not and is caught by
    magnitude instead.
    - ACCEL OFFSET AND SCALE from utils/calibrate_imu.py. These are
    stable, so once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
2026-10-12 Add a software runbook, and fix the panic button
    all_limp.sh listed only 15 of the 18 servos -- leg 3 was missing
    entirely, so the one thing you reach for when the robot is misbehaving
    left a whole leg clamped and loaded. Leg 3 added.
    utils/all_limp.py replaces it for normal use: one pass on one open
    port rather than 15 processes each re-scanning the bus, and it VERIFIES
    each servo actually released, naming any that ignored the write. A
    servo still holding is precisely what you need to know about, and the
    shell version could not tell you.
    software/README.md is a runbook rather than a directory listing --
    organised by what you are trying to do, because that is the question
    you actually have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
2026-10-12 Replace the per-servo scripts with one register-aware tool
    Four tools were stranded in software.old because three of them depend
    on crabora_bus.py, which is the fourth. Porting them would have dragged
    a second bus abstraction into the new tree alongside gait_lib, so
    instead they are rewritten as one command against gait_lib, and the old
    driver can stay retired.
    utils/servo.py addresses registers BY NAME:
    servo.py scan / info 33 / get 33 present_load
    servo.py set 33 torque_limit 500
    servo.py id 1 33 / reset --all / regs
    The named register map is the point. It subsumes scan_ids, set_id,
    reset_overload, servo_report and examine_servo, and means the next
    one-off need -- read this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
2026-10-12 uniBody: say what each BEC actually does
    The two converters have different outputs rather than sharing load:
    5 V for the Pi, 7.4 V for the servo bus via the URTs. Worth recording
    explicitly, because a bare "Qty 2" reads like a split load and it is
    not. The servos are fed by ONE converter, so its rating is the ceiling
    for everything the legs do, and the Pi's draw does not come out of that
    budget.
2026-10-12 Add agentix: chat UI and read-only API
    An agentic layer over the robot. Phase 1 is deliberately READ ONLY:
    nothing the agent can call moves a servo. The plumbing -- nginx, Flask,
    tool dispatch, the UI -- gets shaken out against a robot that cannot be
    damaged by it. Two tibias have already snapped from motions that were
    geometrically wrong, and a model choosing parameters is a new source of
    wrong parameters.
    arbiter.py is the only thing that touches the servo bus. The bus is
    half-duplex and shared, so two concurrent HTTP requests would interleave
    their packets and both get garbage; one lock makes that impossible
    rather than unlikely. It also holds the ports open, because a chat UI
    that takes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
2026-10-12 Add the agent: LangChain + Claude Opus 5.5
    Same shape as NORA, so the pattern is familiar rather than novel.
    Model claude-opus-5-5 with adaptive thinking (it cannot be disabled on
    this model, and budget_tokens is rejected) and effort "low" -- these are
    small lookups over small tool results and the UI should feel quick.
    tool_choice stays auto, since Opus 5.5 rejects forced any/tool.
    A manual tool loop rather than LangGraph: five tools and one decision,
    LangGraph is another dependency on a Pi, and executing the tools here is
    where the safety boundary lives. Every call goes through the arbiter,
    and nothing the model emits reaches a servo except through a function
    listed in tools.py. The emerg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
2026-10-12 Tibia sign verified: close out the last joint TBD
    test_05_calibration.py --signs --legs 1 4 confirms TIBIA_EXTEND_SIGN is
    +1 and uniform across both sides. Legs 1 and 4 are one per side, so that
    single run also settles the mirror question: both extended, so the tibia
    is not mirrored -- same as the femur.
    Two notes for next time. The prediction that it would be uniform held;
    the prediction that it might be -1 "because the femur was" did not. The
    tibia servos follow a different mounting convention, so joints should not
    be assumed to share one.
    This was the last unverified joint sign, so the caveats come out:
    - gait_lib.py: the TBD block becomes a verification note
    - stand/: drops the "test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
2026-10-12 agentix: print a URL you can actually open
    The startup banner printed http://{args.host}:{port}/, and --host
    defaults to 0.0.0.0. That is a bind address meaning "listen on every
    interface", not a destination: a browser pointed at it reports the
    address as unreachable while the server sits there serving happily.
    Copying the printed line is the obvious thing to do, and it fails in a
    way that looks like a network fault -- telnet to the real IP connects,
    so the confusion lands on the browser rather than on the banner.
    Now prints the LAN address first, then loopback, labelled. Finds the
    address by UDP-connecting a socket toward TEST-NET-1 and asking the
    kernel which interface it picked -- no pac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
2026-10-12 agentix: report why the agent is off, not just that it is
    /api/health answered a hardcoded "no model configured" whenever AGENT
    was None. The real exception -- missing ANTHROPIC_API_KEY, langchain not
    installed, a bad model name -- was printed once to the console at
    startup and then dropped, so a browser on another machine saw only an
    amber light and a string that pointed at configuration regardless of the
    actual cause. Diagnosing it meant SSHing to the Pi to read scrollback.
    The reason is now stored where the handler can reach it and reported as
    whatever failed, verbatim.
    Syntax and plumbing checked; flask is not installed on the Mac, so the
    running test happens on the Pi.
    Co-Authored-By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
2026-10-12 agentix: support org-level API keys via workspace header
    An API key that is not scoped to a workspace is rejected with a 400
    telling you to send anthropic-workspace-id. The agent had no way to
    supply one, so an org-level key failed on the first chat request while
    startup looked fine -- the key is present, so build_agent succeeds and
    the failure lands later, in the UI.
    Set ANTHROPIC_WORKSPACE_ID and it goes out as a default header on every
    request. A workspace-scoped key carries its own scope and needs nothing,
    so the header is only attached when the variable is set.
    /api/health now reports which workspace is in play, or "(key-scoped)".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
2026-10-12 agentix: let the agent move the robot, behind an arming gate
    Phase 2. Three different kinds of check stand between a sentence in the
    chat box and a servo moving, and they are deliberately not the same kind
    of thing:
    ARMED (safety.py) -- a human pressed ARM. The agent cannot arm itself:
    /api/arm is a route the tool layer has no way to reach. The window
    expires on idle, has a hard session ceiling, and STOP drops it. The
    failure mode worth designing against is not a model going berserk, it
    is a robot left armed on a bench overnight that lurches when someone
    later asks it an innocent question.
    PREFLIGHT (motion.py) -- bus up, nothing latched, nothing over 65C,
    supply not saggin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
2026-10-12 agentix: format tool results instead of dumping JSON
    Button presses went straight to JSON.stringify. The model summarises its
    own tool results in chat, but the control strip bypasses it, so pressing
    Stand Up produced fifteen lines in which a six-element leg list was six
    lines of punctuation and the outcome was nowhere.
    Results now lead with a sentence saying what happened, then the rows
    that carry new information. Keys the headline already covers are
    suppressed -- repeating "80 mm" under a line that just said it buries
    the rows that matter. Units are attached per key, empty lists read as
    "none", booleans as yes/no.
    The formatter degrades rather than failing on shapes it has no case for:
    un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
2026-10-12 agentix: voice in and out
    Talk: tap, speak, and the transcript is submitted through the same path
    as typing, so there is one way into chat. Stops on its own at a pause.
    Voice: reads replies aloud, pitched slightly low.
    STOP now cancels both. An emergency stop competing with a voice calmly
    finishing the previous answer is not a good moment.
    The constraint worth knowing is that speech recognition requires a
    secure context, and the Pi serves plain http on a LAN address. Rather
    than let the first tap die with a bare "not-allowed", the button detects
    it up front and says "Mic blocked", with a title explaining that an SSH
    tunnel to localhost fixes it -- which it does, and which also happens to
    s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
2026-10-12 walk: translate the body with the feet planted
    There was no forward-walking program. The missing piece was never the
    gait cycle -- it was the planted-foot solve, and turn.py already had it.
    Walking is that maths with translation substituted for rotation. Both
    are "foot fixed in the world, re-solve the leg at every interpolated
    point"; the only difference is whether the foot appears to rotate about
    the body centre or slide opposite the heading. run_walk is deliberately
    the same shape as run_turn, down to the cancellation poll, so the two
    read alike and neither becomes the odd one out.
    Heading is a vector rather than a flag, because a hexagon with radial
    legs has no mechanical front: it walk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
2026-10-12 net: let the robot be its own WiFi access point
    A robot that walks needs to be reachable away from the house network.
    Set up as a FALLBACK rather than a switch, which is the whole design.
    The Pi has one radio and concurrent AP+client on brcmfmac is flaky, so
    it is one or the other. Known networks get a high autoconnect priority
    and the AP gets a low one -- an AP always succeeds where an
    infrastructure profile only succeeds in range, so without that gap the
    AP would win at every boot. With it, the robot joins the house network
    at home and becomes 'crabora' in the garden, with nothing to toggle.
    WPA2 with a real passphrase, and no option for an open network: anyone
    who joins reaches the agen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
2026-10-13 bus: retry a lost reply, and say when it happened
    "servo 52: goal: There is no status packet!" aborted a whole motion on
    a single dropped packet. The bus is half-duplex and shared, and six
    servos switching current is an electrically noisy place, so losing the
    occasional reply is normal and not worth stopping a gait over.
    But a retry that hides a fault is worse than the abort was. A browning
    -out supply drops packets exactly like a loose connector does, and with
    the LM2596 running about 1 V above its dropout that is the likelier
    cause here. So retries are COUNTED, reset per motion, and reported: a
    motion that completed after forty re-sends now says so, in amber, above
    the result. Previously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
2026-10-13 walk: measure the stance instead of assuming it, and fix to_degrees misuse
    Tom reports the robot dragging its legs rather than lifting them clear.
    The gait is not the problem. Computed against the real geometry, a 25
    degree femur lift gives 51-69 mm of foot clearance, move_group does
    block until each phase arrives, and the lift is held through the whole
    sweep. The command sequence is right.
    What was wrong is that walk.py took --height on faith. If the robot is
    not actually up at that height -- never stood, or sagged under its own
    weight because the supply cannot hold it -- the swing legs lift 50 mm
    into a body that is sitting 60 mm too low, and the feet scuff. From the
    outside that is indi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
2026-10-13 tests: does a tripod actually leave the floor?
    The walk drags its feet, and the gait is not obviously wrong -- lift,
    swing, plant, alternate, which is the right shape. Computed against the
    real geometry a 25 degree femur lift gives 51 mm of clearance.
    But 51 mm of clearance is also 51 mm of permission to sag, and that is
    the part I had not thought about. During a tripod gait THREE legs carry
    the whole robot, twice what each carried standing on six. If the body
    drops by roughly the lift amount when half the legs come up, the raised
    feet never leave the floor -- and that looks identical, from the
    outside, to a gait with no lift in it.
    This test separates the two without walking. It stands, l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
2026-10-13 walk: measure swing clearance during the walk, and fix a voltage read
    test_07 came back clean: 64 mm of clearance, swing femurs within 2
    degrees of target, stance legs giving about 1 degree, and the body
    RISING 4 mm rather than sagging. So the lift works, the supply holds
    under three-leg load, and both of my explanations for the dragging were
    wrong. It is something about the walk itself.
    So take the same measurement where the problem actually is. --instrument
    reports swing-foot clearance after the LIFT and after the SWEEP of every
    step, computed from present angles against the stance legs' own implied
    floor. Standing still and lifting is not the same as lifting while the
    stance legs are mov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
2026-10-13 test 7: ask the operator, and stop quoting a height that is not a gap
    Two things, both from the same lesson: the model was telling me numbers
    that did not describe the robot.
    First, test 7 computed 64 mm of foot clearance and PASSED. Tom watched
    the same lift and the legs did not leave the floor. Computing clearance
    from joint angles can only restate your assumptions back to you, so the
    test now lifts the tripod and ASKS, then puts it back down.
    The computed figure is still printed beside the answer, because the
    disagreement is the most valuable thing the test can produce. When the
    robot says 64 mm and the operator says still touching, the pose model is
    wrong -- link lengths, an angle conv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
2026-10-13 walk: the femur caps are the constraint, not the feet
    Measured on hardware: the chassis sits 46 mm off the floor standing, and
    drops to 33 mm when one tripod lifts. Thirteen millimetres of sag while
    the stance femurs gave about one degree -- so it is mechanical, not
    commanded. Structural flex, horn and gear backlash, feet sliding outward
    under the doubled load, or all three. The encoders cannot see any of it,
    which means every clearance computed from joint angles is optimistic by
    at least that much, and by more under a moving load.
    Recorded as TRIPOD_SAG, with tripod_gap() combining it with the cap drop
    to answer the question that actually matters: how much room is under the
    lowest part of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
2026-10-13 walk: raise the default lift to 35 degrees
    The feet were observed scraping. Computed, the old 25 degree lift holds
    the swing foot 50-68 mm above the floor for the whole swing, so on paper
    it had 50 mm of margin and should never have touched.
    The gap between those two is sag, and more of it than the 13 mm measured
    statically in test 7. That test held the stance legs still; during a
    sweep they are being commanded to change angle while carrying the whole
    robot, and a loaded servo that is moving holds far worse than one that is
    not. None of it reaches the encoders, so no amount of computing from
    joint angles will ever show it.
    35 degrees buys 24 mm more clearance and costs nothing -- the femur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
2026-10-13 bus: survive a serial exception, and say when the service has the port
    stand.py crashed mid-collapse with a pyserial traceback: "device reports
    readiness to read but returned no data (device disconnected or multiple
    access on port?)".
    Two bugs, and the error message names the real one itself.
    First, the retry wrapper only handled failures the SDK REPORTS as a
    status code. pyserial can also RAISE, and that escaped as a traceback
    from whichever phase happened to be running -- a poor way to discover
    that something else holds the port, and worse mid-collapse, where the
    robot is left part-way through a sequence. Serial exceptions are now
    retried like any other lost reply, and a persistent one b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
2026-10-13 stand: untangle all legs together, not one at a time
    Faster, and safer, which was the surprise. One leg at a time meant a leg
    whose turn had come rotated its coxa while its neighbours were still
    lying extended on the floor -- so the exact thing the phase exists to
    prevent, a 440 mm lever sweeping through another leg, was still possible
    BETWEEN legs even though it was carefully prevented within one.
    Two global passes remove that: nothing rotates until everything is
    folded and lifted. Screen every leg against its own travel limits, raise
    every femur, fold every tibia, and only then rotate every coxa.
    Femurs before tibias, for the same reason COLLAPSE does it that way:
    folding a knee while th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
2026-10-14 doc: IMU bring-up, written for Ubuntu rather than Raspberry Pi OS
    Every MPU-6050 guide reaches for raspi-config and /boot/config.txt.
    Neither exists here: Crabora runs Ubuntu, where I2C is enabled by adding
    dtparam=i2c_arm=on to /boot/firmware/config.txt, the i2c group needs a
    log out before the shell sees it, and PEP 668 refuses a bare pip install
    into the system Python, so smbus2 goes in the project venv.
    Covers wiring with the pin numbers, why 3.3 V rather than 5 V (the
    breakout's pull-ups would put 5 V on the Pi's GPIO), the orientation that
    has to match the body frame, enabling the bus, finding the chip, the
    mount check, calibration, and a troubleshooting table.
    Two things are called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
2026-10-14 imu: C-section bracket for the MPU-6050
    Base glues to the deck, web sets the wiring clearance, top plate carries
    the board. Open side forward, so a nut can be started on a bolt dropped
    through the top plate and the wiring leaves underneath unpinched.
    35 mm gap as specified. Board 20 x 16, M3 holes 14.5 mm on centres --
    derived from 17.5 mm measured outside-to-outside, which is how a caliper
    can actually reach them. The holes run along the board's LENGTH: 17.5 mm
    of span does not fit across a 16 mm board, so the bolts are fore and aft.
    The engraved arrow matters more than the bracket. Two bolt holes cannot
    key rotation, so the board fits perfectly mounted 180 degrees out with
    +X pointing af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
2026-10-14 imu bracket: holes across the plate, and a nut trap that fits
    Two changes.
    The bolt holes rotate 90 degrees, so they now run across the plate
    rather than fore and aft, and the board's long axis sits athwart the
    robot. The plate widens to suit -- 22.9 mm, taken as the larger of the
    board footprint and the bolt span plus clearance, rather than assuming
    the board is always the wider of the two.
    The nut trap was unbuildable as written. A 2.6 mm hex pocket in a 3 mm
    plate leaves 0.4 mm of PLA above the nut, and that 0.4 mm is what the
    bolt clamps against -- it would crush on first tightening. The top plate
    now grows to 4.6 mm whenever a trap is asked for, keeping 2 mm of
    material over the nut,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
2026-10-14 imu bracket: drop the arrow, stop the top plate past the bolts
    The engraved arrow is gone -- not wanted.
    The top plate now ends 6 mm past the bolt centres instead of carrying
    the whole board: 24.5 mm rather than 40. The board is held at its holes,
    and plate beyond them is only mass on the end of a 35 mm cantilever. The
    PCB overhangs the front, where nothing bears on it. Volume drops from
    9.7 to 8.6 cm3 and the mass comes off the worst possible place for it.
    The base keeps its full 31.5 mm. It is the glue joint under a 41 mm
    tall bracket, and length there resists the peeling moment rather than
    adding to it.
    Losing the arrow means nothing on the part keys rotation any more, so
    that is now c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
2026-10-14 test 7: measure body attitude during the lift
    The IMU sees the one thing the servo encoders structurally cannot --
    where the body actually is. Every dead end chasing the dragging gait
    came from that gap: joints reported arriving at their commanded angles
    while the chassis sat 13 mm lower than the model believed.
    So test 7 now samples roll and pitch with the robot standing, again with
    the tripod up, and reports the change plus what it costs at the feet.
    One degree of tilt is 6 mm at a foot 341 mm from the body centre, which
    makes the ruler measurement and the sensor directly comparable for the
    first time.
    Stated in the test rather than buried: an accelerometer measures TILT,
    not height. A b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
2026-10-14 gitignore: catch .venv-cad and any other venv variant
    A bare `.venv/` did not match `.venv-cad/`, so a CAD virtualenv went in
    with a `git add -A` -- 177 MB of macOS-ARM wheels across 5067 files,
    pushed, and then pulled onto the Pi where they cannot run at all.
    `.venv*/` catches the whole family. The history has been purged
    separately; this stops it happening again.
2026-10-14 test 7: fix two bugs I shipped in the IMU change
    NameError on att_before. The edit that was supposed to set it targeted
    two adjacent lines that are not adjacent -- h_before sits between them --
    so the replacement silently did nothing and only the USE of the variable
    landed. A syntax check cannot catch a name that is only referenced at
    runtime, and that is all I ran.
    And math was never imported, although report_tilt uses hypot, degrees,
    radians and sin. That would have crashed on the next line after the
    first fix.
    Both found by running pyflakes rather than ast.parse. Linting the rest
    of today's edits for undefined names came back clean, so this was
    contained to the one file.
    The lesson, re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
2026-10-14 test 7: default lift to 35, and spot the robot sitting on its caps
    Tom reports the lifted tripod only a few millimetres off the floor while
    the test computed 56-57 mm. Those two numbers differ by 54 mm, and the
    gap under the femur caps at that stance is 54 mm. Same number.
    So the body is sinking until the chassis reaches the floor, and the feet
    end up wherever that leaves them. The computed figure is body-relative
    and structurally cannot see this: it measures the swing foot against the
    stance feet, both of which move down together when the body drops.
    The test now checks for it. When the shortfall matches the cap gap it
    says so, and says that more lift cannot fix it -- raising the feet
    rel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
2026-10-14 test 7: wait for the move before measuring it
    All three swing femurs reported 9 degrees short of their target, which
    reads as three legs failing under load. They were not. The settle was a
    flat 1.5 s and a 35 degree lift at 200 counts/s takes 1.99 s, so the
    measurement caught them mid-flight: 1.5 s buys 26.4 degrees of the 35
    asked, and they had travelled 25.8.
    The settle now adds the move's own travel time, so --settle means "extra
    time after it should have arrived" rather than "total time, hope that is
    enough". The wait is printed with the result, so a short read is visible
    rather than inferred.
    This was hiding because the old 25 degree default takes 1.42 s and just
    fitted inside the 1.5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
2026-10-14 walk: instrument body attitude and heading, not just joint angles
    --instrument measured swing clearance from joint angles, which is
    body-relative and so structurally blind to the body moving -- the exact
    gap that sent me chasing the wrong cause for most of an evening. It now
    also reports body tilt at each LIFT and SWEEP, and the heading change
    across the whole walk.
    Heading is the one thing a walk can measure that a static lift cannot. A
    straight walk should finish on the heading it started on, so a veer is
    asymmetric slip, one side gripping better than the other -- and over
    150 mm that is invisible by eye. It is zeroed at the setup pose, the one
    moment the robot is reliably standing still.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
2026-10-14 stand, walk: default height 100 mm, not 80
    80 was chosen before anyone knew the femur caps hang 21 mm below the
    deck, or that the body drops another ~13 mm when a tripod lifts. Those
    two together leave about 46 mm of real gap under the lowest hardware at
    80, against 66 at 100 -- and 46 is where the chassis starts bottoming out
    instead of the legs holding it up.
    Measured on hardware today: standing at 94 mm gave 73 mm under the caps
    and a clean tripod lift at 35 degrees. 75 mm, earlier the same evening,
    left the lifted feet a few millimetres off the floor.
    It costs almost nothing. Stride capacity drops from +/-84 mm to +/-72 mm,
    still far more than the 50 mm default stride uses, and the sta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
2026-10-17 walk: add scurry.py, the walk gait streamed on a clock
    walk.py stops dead seven times a step: each frame writes 18 goals one
    packet at a time and polls every servo until all have stopped, at 300
    steps/s. scurry.py keeps walk.py's stance_pose() geometry and instead
    sends every goal at 50 Hz in one sync-write per URT, with no waiting.
    Duty 0.55 so both tripods overlap at each changeover, a Hermite swing
    and raised-cosine lift so feet leave and land with no velocity jump, and
    a ramped cycle rate at each end. It is open loop, so it reads supply
    voltage every 0.2 s and stops below 6.5 V, and ends on any bus error by
    planting the swing feet and holding.
    Default 3 s cycle (~28 mm/s). --dry-run re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
2026-10-17 walk, turn: wrap the coxa angle, so the left legs stop pinning at their limit
    stance_pose() in both programs computed the coxa as atan2(...) - phi
    without wrapping. For the left legs phi is -210..-330 degrees, so the
    result came out near 360: the right direction, one turn round.
    pose_counts() made that about 6000 counts and clamp() then held each
    left coxa (legs 4-6) at its firmware maximum, so on every walk and turn
    those three coxas sat at their travel stop instead of tracking.
    The dry-runs never showed it, because they print _normalise()d angles.
    Wrapped to +/-180 where the angle is computed. Dry-run output is
    unchanged; what reaches the servos is not, so expect walk and turn to
    behave d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
2026-10-17 agentix: add scurry to the web UI and the agent
    A Scurry button beside Walk (300 mm forward, 3 s cycles), and a scurry
    motion tool taking distance, direction and period (2-6 s). It calls
    scurry.plan() and run_scurry() rather than reimplementing them, and
    refuses any period the femurs cannot follow; there is no --allow-fast
    from here. Before moving it checks the robot is standing and the supply
    has headroom. STOP ends the stream the same way a voltage sag does:
    feet planted, torque on.
    The agent's prompt names scurry as high-risk and unproven on hardware,
    to be used only when speed is what was asked for.
2026-10-17 stand, turn, dance: one height, 100 mm, everywhere
    stand.py and walk.py moved to 100 mm in 5826c79, but the web UI's Stand
    button still called motion.stand() with its old 80 mm default (it reads
    about 75 once it sags), and turn.py and dance.py still worked at 80. So
    standing then turning or dancing dropped the body 20 mm first, back to
    the height where the femur caps scrape.
    All of them are 100 now: motion.stand's default and the agent's schema
    and help text, turn.DEFAULT_HEIGHT and dance.DEFAULT_HEIGHT. Checked at
    100: turn plans with its 15 degree half-sweep against a 28.5 degree cap,
    and all five dance moves still solve.
2026-10-17 agentix web: drop the read-only / motion armed label
    The ARM button already says ARMED and counts down while motion is
    allowed, so the pill beside the name repeated it in both states.
2026-10-23 doc: add power architecture (PRIPOWER, LOCOPOWER, LOGIPOWER)
    New doc/power.md splits power into three domains: batteries, servo
    power, and logic power. Records today's LM2596/2S setup, the planned
    3S + 20 A buck upgrade, load estimates, and the gotchas (brownout looks
    like wiring faults; a regulating buck hides a low pack from preflight).
    bringUp.md's stale 5 A bench-PSU note and uniBody.md now point to it.
2026-10-25 agentix: wait for the mic to open before saying Speak now
    Chrome fires "start" at once but its speech service takes ~4.8 s to
    reach "audiostart". The button lit up on "start", so speech went into a
    mic that was not open yet and every attempt ended in no-speech. Show
    Wait... until audiostart, then Speak now.
    Also: say every failure in the chat (start() throwing, blocked page on
    tap), only send what was actually heard, and keep quiet on aborted.
2026-10-25 agentix: pitch/roll widget from the IMU
    Two small views of the robot above the chat -- from behind for roll,
    from the right side for pitch -- tilting by the true angle, coloured at
    5 and 15 degrees, greyed when there is no reading. Polls a new quiet
    GET /api/imu once a second while the page is visible; that route is not
    under the servo bus and is kept out of the access log.
    "Moving" is judged on g alone: imu_state never zeroes the gyro, so its
    own still flag reads false on a robot sat on the bench.
2026-10-25 imu_lib: undo the board's 180-degree turn on the deck
    The web tilt gauge showed nose-up as nose-down and roll reversed. A
    board turned half round flat on the deck flips X and Y and leaves Z
    alone -- exactly that -- and test_06's gravity check cannot see it.
    MOUNT_YAW_DEG rotates accel and gyro into the body frame after
    calibration, so stored offsets and gyro bias stay valid.
2026-10-25 agentix: hands-free voice conversation
    Tap Talk once: it listens, sends, reads the reply aloud, and listens
    again until tapped off, STOP, or three silent listens. Never listens
    while speaking, so it cannot hear its own reply. Replies are always
    spoken in a conversation; Voice now only covers typed questions.
    Speech is queued per sentence so Chrome's cut-off of long utterances
    cannot stall the loop.
2026-10-25 agentix: markdown replies, spoken summary, always armed
    Replies render as Markdown (tables, code, small inline SVG), parsed by
    marked and sanitised by DOMPurify, pinned from cdnjs; plain paragraphs
    if they fail to load.
    Only a ~20-word summary is spoken. The model ends each reply with a
    SAY: line; split_spoken() strips it and returns it as `spoken`, so no
    second model call. Missing line -> opening sentences, Markdown removed.
    No ARM button: ALWAYS_ARMED in app.py turns the safety gate off, so
    motion -- the agent's included -- is allowed at any time and STOP no
    longer locks it afterwards. Tom's call. The window gate stays in
    safety.py and comes back by flipping the flag and restoring the bu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
2026-10-25 agentix: voice picker
    A dropdown beside Voice, filled from the browser's own voices and
    grouped Robot / Speaking / Silly / Other languages. Picking one says a
    sample line in it; the choice is remembered per browser. Network
    voices are marked so their lag is not a surprise.
2026-10-25 agentix: HAL voice preset
    A Presets group in the voice picker. HAL is a calm male voice (Daniel,
    else Reed / Google UK Male / Eddy / Rocko, whichever the machine has)
    at rate and pitch 0.85, with its own sample lines. Presets carry rate
    and pitch, so speak() now takes them from the choice.
2026-10-25 doc: record the XINGYHENG 20 A buck ordered for LOCOPOWER
    What the listing confirms (6-40 V in, 1.2-36 V out, 20 A / 300 W,
    CV/CC, short-circuit protection), what it does not (continuous rating,
    cooling), that it needs the 3S pack to regulate, and the no-load setup
    steps: 7.4 V, CC ~8 A for bring-up, output cap, then check servo volts.
2026-10-25 agentix: animated leg view with a leg picker
    Side view (femur, tibia, from pose.leg_fk) and top view (coxa swing)
    of one chosen leg, polled from a new GET /api/leg/<n> four times a
    second and eased between readings.
    Measured when the bus is free; while a motion holds it, the goals the
    gait last wrote, tagged "commanded". gait_lib.write2 and scurry's sync
    write now record those goals in LAST_GOALS -- passive, nothing decides
    anything from it. Arbiter.try_positions never waits, so the view
    cannot delay or interleave with a motion. /api/leg is kept out of the
    access log.
2026-10-26 doc: the Pi's 5 V BEC is an LM2596, fine on 3S
    Rated to 40 V in, so the 3S pack needs no change on the LOGIPOWER side.
    About 2 A continuous against a Pi 3's 2.5 A peak: swap for a 3 A+
    converter, set to 5.1 V, before a camera goes on.
2026-10-28 power: 3S pack in, LM2596 still the servo buck, 20 A buck returned
    The 3S pack lets the LM2596 regulate 7.4 V for the first time, but its
    ~2 A ceiling is unchanged. The XINGYHENG 20 A buck arrived defective and
    is going back. Servo voltage below 7.4 V now means the buck is at its
    current limit, not a low pack, so update power.md, the README, the
    motion.py voltage-floor comment and the agent's system prompt to match.
2026-10-28 agentix: show live servo current in the web UI
    gait_lib.read_status() reads position, moving and current in one round
    trip and leaves the current in LAST_CURRENT. stand.move_group uses it,
    so stand, walk, turn and dance all leave power readings behind while
    they hold the bus, and poll a little faster than with two reads.
    /api/current serves them: measured from every servo when the bus is
    free, the motion's own readings otherwise. The new power panel shows
    amps per joint and the summed draw against the LM2596's ~2 A.
    Amps per count (6.5 mA) is from Feetech's table, not yet checked
    against a meter.
2026-10-28 scurry: faster defaults, honest stride cap, acceleration and lag
    Body speed comes from stride and femur speed from lift, so the defaults
    move from walk.py's 50 mm / 35 deg to a 120 mm stride, 20 deg lift and
    feet 110 mm out (moved in from the stand pose and back). Same 3 s cycle,
    67 mm/s planned instead of 30.
    - The stride cap now allows for the swing's Hermite overshoot, so a
    stride near the limit is capped instead of failing "beyond reach".
    - Past ~1.6 s cycles the stream needs more than the acceleration
    register's 254; it goes unlimited rather than silently lagging, and
    suggests --rate 100.
    - Every 0.05 s it reads one servo's position and current, and reports
    each joint's trackin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
2026-10-28 scare!: rear up on legs 2-5 and wave legs 1 and 6
    Standing on 2-5 puts the centre of mass on the line between feet 2 and
    5, so legs 2 and 5 first step 60 mm forward, one at a time with five
    feet down -- 60 mm of margin, and it refuses under 35. Then legs 1 and
    6 rear up, curled and pointing forward, and wave out of phase. It ends
    by lowering them and stepping back to standing.
    A supply sag or Ctrl-C lowers and steps back; a UI STOP leaves it to
    STOP's torque drop. Built from pose_stand, walk.stance_pose and
    dance.play. agentix gets a scare motion (waves 1-12) and a Scare!
    button. Checked against a fake bus; not yet run on hardware.
